gbq38u/spider_gaming/code_claws/firmware/README-claw-radio.md

# Пульт двух клешней: прошивки и подключение

## Файлы

- `claw_remote_nano/claw_remote_nano.ino` — прошивка пульта Arduino Nano.
- `../esp_spider3_copy_20261016134133/esp_spider3_copy_20261016134133.ino` — существующая программа ESP32 с подключённым управлением клешнями.
- `../esp_spider3_copy_20261016134133/claw_radio_esp32.h` — код приёмника и движения шести сервоприводов. Хранить в той же папке, что и основной `.ino`.

Установить библиотеки **RF24 (TMRh20)** и **Adafruit PWM Servo Driver Library** (включая Adafruit BusIO). Основная программа ESP32 также требует свои прежние библиотеки micro-ROS. RF24 и Adafruit используются в актуальных API `begin/openWritingPipe/openReadingPipe/read/write` и `writeMicroseconds`.

## Подключение пульта

| Элемент | Nano |
| --- | --- |
| Левый VRx / VRy / SW | A0 / A1 / D3 |
| Правый VRx / VRy / SW | A2 / A3 / D4 |
| Радио CE / CSN / SCK / MOSI / MISO | D9 / D10 / D13 / D11 / D12 |

Кнопки джойстиков замыкают SW на GND, поэтому в коде включена внутренняя подтяжка. Оба джойстика питаются от 5 В Nano. Питание YL-105 — 5 В после MT3608, nRF24L01+ вставляется в адаптер и получает 3,3 В с него. Выходы Nano D9/D10/D13/D11 подключать к адаптеру **через четыре делителя 1 кОм последовательно + 1,8 кОм на землю**, как на схеме пульта; MISO идёт прямо на D12. Конденсаторы 10 мкФ и 100 нФ стоят на выходе 3,3 В адаптера. Если при исправной разводке приём не работает, уровень MISO 3,3 В может быть недостаточен для конкретного 5-вольтового Nano; тогда нужен согласующий буфер.

## Разъёмы клешней платы v13

| Клешня | Движение | Разъём | PCA9685, канал | Питание +5 В |
| --- | --- | --- | --- | --- |
| Левая | Поворот | J19 | 0x40, 6 | группа C |
| Левая | Подъём | J20 | 0x40, 5 | группа B |
| Левая | Захват | J21 | 0x40, 4 | группа A |
| Правая | Поворот | J22 | 0x41, 6 | группа C |
| Правая | Подъём | J23 | 0x41, 5 | группа B |
| Правая | Захват | J24 | 0x41, 4 | группа A |

Каждый разъём: контакт 1 — сигнал, 2 — соответствующие +5 В, 3 — GND. Не объединять три группы +5 В. На ESP32 радио: CE=GPIO25, CSN=GPIO26, SCK=GPIO18, MOSI=GPIO23, MISO=GPIO19. J_RF.2 подаёт 5 В на **вход** YL-105. IRQ=GPIO27 коду не нужен: приём идёт опросом; перемычка RF8 необязательна для работы этой прошивки.

## Поведение

Каждый джойстик управляет своей клешнёй. Влево/вправо — поворот; вперёд/назад — подъём/опускание. Чем дальше отклонён рычаг, тем быстрее движение. Отпущенный рычаг сохраняет положение. Одно нажатие кнопки переключает открыто/закрыто. Повторяемые пакеты несут именно состояние захвата, поэтому потерянный пакет не создаёт второго переключения. При потере радиосвязи более чем на 300 мс движение поворота и подъёма прекращается, захват остаётся в последнем состоянии.

При включении держите джойстики по центру: Nano калибрует четыре середины за ~0,13 с. ESP32 не двигает клешни до первого корректного пакета; затем задаёт нейтральные 1500 мкс и плавно переводит губки к состоянию «открыто». При загрузке прошивки и первой проверке снимите качалки: реальные нули, крайние углы и направление электрического хода SG90 зависят от установки. Константы `kAxisSign` в пульте и `kYawDirection`, `kPitchDirection`, `kMinUs`, `kMaxUs`, `kOpenUs`, `kClosedUs` в приёмнике позволяют откалибровать направления и пределы. Текущий диапазон 1250–1750 мкс — начальный осторожный диапазон, а не подтверждённый полный ход геометрии клешней. Геометрические положения −73° (рабочее) и +20° (ходовое) из модели не равны углам PWM.

Чтобы не задеть передние ноги, сначала проверьте их разведение, а затем расширяйте предел опускания клешней. Перед сведением ног поднимайте клешни. Программный ограничитель столкновений с ногами пока не задан: для него нужна проверенная фактическая кинематика вместе с установленными сервами.

## Встраивание в программу паука

В существующем `.ino` приёмник уже подключён. Там `pca2` имеет адрес **0x40**, а `pca1` — **0x41**, поэтому вызов `ClawRadio::begin(pca2, pca1, pcaBusMutex)` дан именно в таком порядке. Код создаёт отдельную задачу ESP32, которая продолжает принимать радио, пока micro-ROS ждёт агента. Общий мьютекс защищает I²C от одновременной записи ног и клешней. Управление ногами остаётся в прежних таймерах micro-ROS.

Таблица `servoPorts` и привязка `legLF/.../legRR` в существующем `.ino` были приведены к текущей плате v13: J1–J3 — левая передняя нога; J4–J6 — правая передняя; J7–J9 — левая средняя; J10–J12 — правая средняя; J13–J15 — левая задняя; J16–J18 — правая задняя. Если физически ваши 18 серв подключены в другом порядке, адаптируйте эту таблицу перед включением.

Полная компиляция основной программы требует установленной среды Arduino ESP32, RF24, Adafruit и micro-ROS с `spider_interfaces`. В этом окружении Arduino CLI и RF24 не установлены; код обоих новых модулей проверен компилятором C++11 с заглушками зависимостей. Работа на фактическом пульте и клешнях требует проверки при сборке.
