gbq38u/spider_gaming/images/2026-10-07 08.31.48.jpg

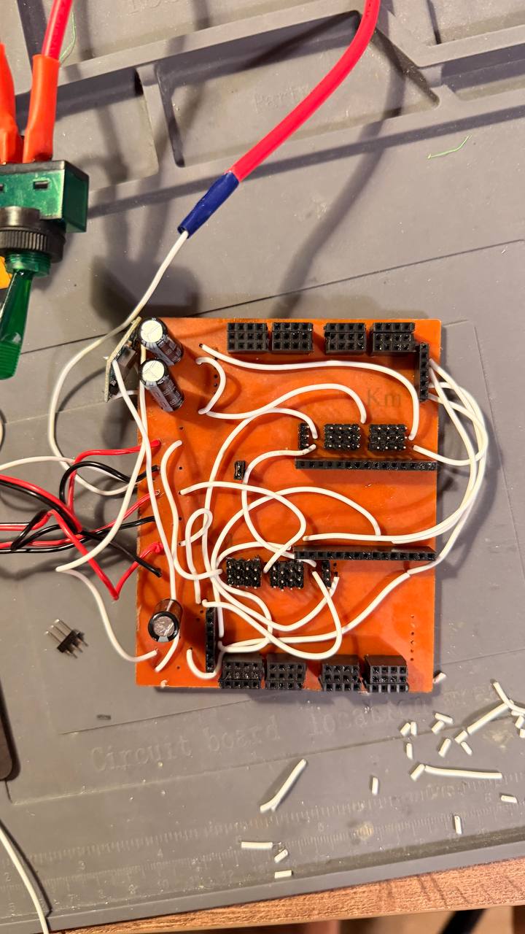
images/2026-10-07 08.31.48.jpg
