gbq38u/spider_gaming/images/2026-10-07 08.31.58.jpg

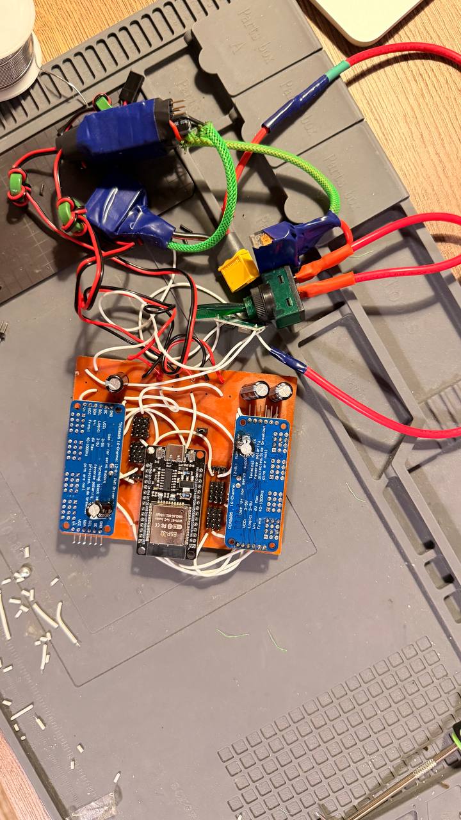
images/2026-10-07 08.31.58.jpg
