gbq38u/spider_gaming/images/2026-10-07 08.32.05.jpg

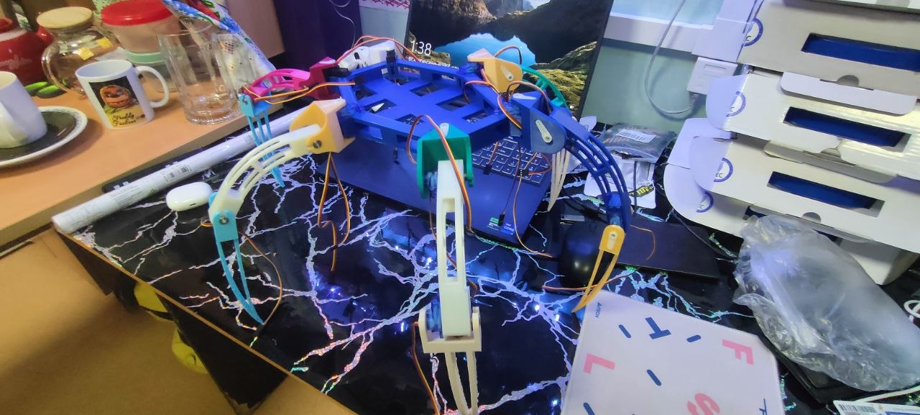
images/2026-10-07 08.32.05.jpg
