gbq38u/spider_gaming/images/desmos_screen1.png

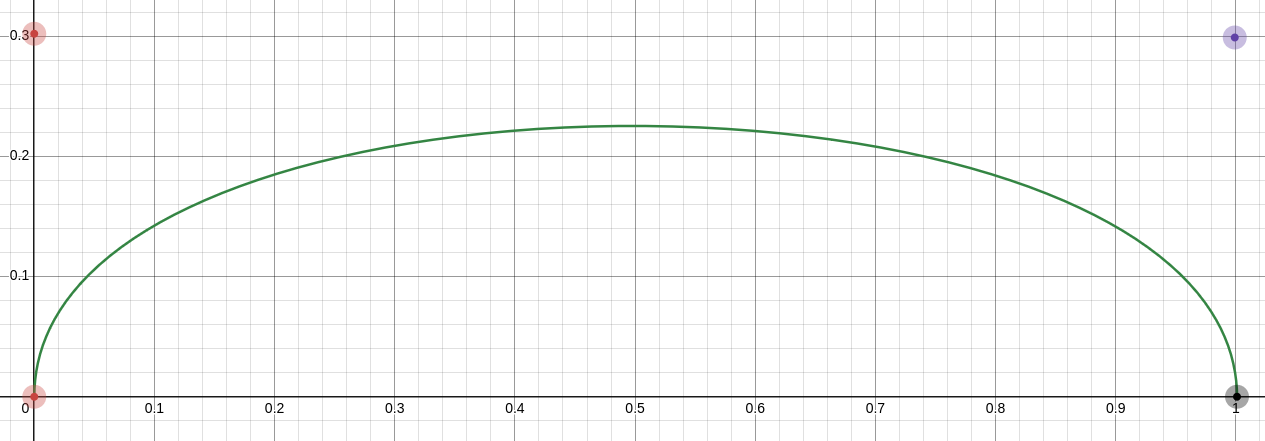
images/desmos_screen1.png
