gbq38u/spider_gaming/parts/spider_remote_2joystick_PETG_v1/preview/controller_with_hardware_concept.png

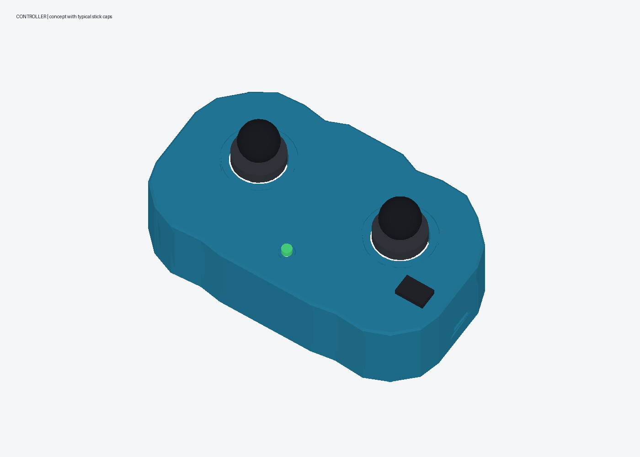
parts/spider_remote_2joystick_PETG_v1/preview/controller_with_hardware_concept.png
