gbq38u/spider_gaming/parts/claws_petg_SG90_2x3_v12 2/README_RU.md

# Две трёхприводные клешни для паука — версия 12

Размеры в миллиметрах. Основа проекта — предоставленные `main_frame.STL`, `servo.STL`, `Assembled_spider_light.STL` и детали ног из папки `SPIDER_LIGHT`. Оригинальную раму перепечатывать не требуется. В просмотрочных сборках вертикаль робота — Z, движение вперёд — Y. Перед корпуса соответствует стороне +Z исходной `main_frame.STL`.

## Что печатать

В `print_stl/` находятся детали, уже уложенные на плоскость печати. Для каждой стороны (`left`, `right`) нужно **по одной**: `yaw_base`, `pitch_cradle`, `boom`, `gripper_holder`, `gear_bridge`, `jaw_carrier`, `jaw_driven`, `jaw_passive` — всего 16 основных STL. `jaw_carrier` — отдельная несущая деталь под ведущей шестернёй, которую качалка прижимает к серве. Детали не нужно отражать или копировать. Отдельных гаек и печатных проставок для осей подшипников **нет**. Две направляющие `drill_jig` необязательны. Перед основным комплектом напечатайте по одному `servo_fit_coupon`, `horn_fit_coupon`, `bearing_fit_coupon`, `m3_pilot_fit_coupon` и проверьте реальные серву, качалку, подшипник и усилие вкручивания M3. Детали разных версий между собой не смешивать.

`claws_assembly_work.stl` и `claws_assembly_walk.stl` показывают обе клешни с сервами, штатными качалками и подшипниками. `claw_left_assembly_work.stl` и `claw_right_assembly_work.stl` показывают стороны отдельно. `spider_with_claws_reference.stl` показывает рабочую позу с разведёнными передними ногами; `spider_with_claws_unspread_reference.stl` — сравнение с исходным положением ног. Эти файлы **не печатать**. `preview/` содержит изображения и схему сверления.

## Крепление к раме

Сверлить раму на стороне +Z исходной `main_frame.STL`:

| Клешня | X, мм | Z, мм | Отверстий |
|---|---|---|---:|
| Левая | 81 и 89 | 251 и 258 | 4 |
| Правая | 97 и 105 | 251 и 258 | 4 |

Сверло Ø3,3–3,4 мм. Четыре отверстия каждого основания приходятся на сплошную поперечину рамы; разметка рамы остаётся прежней. Оси боксов поворота расположены **над креплениями передних ног**, в просмотрочной сборке X=115 и 241,5 мм, Y=333 мм. Палуба бокса поднята на 32 мм над верхом рамы. Её держат две стойки сечением 6 × 3,6 мм, две перемычки шириной 5,2 мм и косые распорки Ø5,8 мм. Минимальный оценочный зазор от нижнего края подшипникового узла до передней ноги в рабочей позе — около 10,5 мм. Приложите напечатанные основания и проверьте полный ход передних ног **до сверления**. Ориентир крепежа: восемь болтов M3×30 с шайбами и гайками; длину уточните по реальной раме. Схема `preview/mount_drilling.png` не является бумажным шаблоном 1:1.

## Штатные качалки и подшипники

Все три сервы каждой клешни используют **штатную одноплечую качалку**, установленную на шлиц сервы. По исходному `hanger.STL` габарит в плане — 21,673 × 7,33 мм, толщина ступицы 4 мм. У неё нижние 2 мм занимает в основном ступица, а длинное плечо лежит на уровне 2–4 мм. Теперь на всех трёх приводных осях **между сервой и длинным плечом качалки остаётся сплошная печатная полка толщиной 2 мм**. Ступица проходит через центральное отверстие, качалка устанавливается с наружной стороны полки и прижимает её к серве. Наружные окна дают доступ к центральному винту вала и винтам плеча; сама полка под плечом больше не прорезана сквозным пазом. Исходная модель качалки **не содержит отверстий под винты плеча**, поэтому после примерки разметьте и просверлите небольшие пилоты в полке через отверстия вашей физической качалки. Не сверлите их наугад по STL качалки.

На противоположной стороне каждого из трёх приводных шарниров стоит подшипник **3×8×4 мм** (тип MR83 или эквивалент). Ещё один такой же подшипник поддерживает пассивную губку каждой клешни: всего **восемь**. В `spider_leg_L1.STL` измерена посадка Ø8,1 мм глубиной 3,9 мм; в `spider_leg_L3_new_new.STL` — Ø8,0 мм глубиной 3,9 мм. Для PETG выбран карман Ø8,1 мм глубиной 4,1–4,2 мм. Подшипник запрессовывается наружным кольцом в карман, его внутреннее кольцо надевается на винт M3; гайки и отдельной печатной проставки нет. Пилот Ø2,7 мм для винта остаётся гладким в STL — резьбу формирует сам винт при аккуратной установке. Встроенный выступ Ø4,8 мм ответной детали подходит к внутреннему кольцу. Реальное усилие посадки проверьте на пробнике `bearing_fit_coupon`.

- **Поворот:** полка `pitch_cradle` находится между сервой и плечом качалки; качалку ставят **сверху, после установки этой детали**. Подшипник запрессовывается **снизу** в её нижнюю вилку. До установки сервы в `yaw_base` вкрутите M3 **изнутри бокса вниз** через сквозной пилот Ø2,7 мм. Головка Ø≤5,5 мм и высотой ≤3 мм утапливается в гнездо Ø5,9 × 3,2 мм заподлицо с дном бокса. Нижний выступ винта входит прямо в отверстие внутреннего кольца подшипника, без гайки.
- **Подъём:** полка внутренней ветви `boom` находится между сервой и качалкой; качалку ставят **снаружи после установки плеча**. Подшипник запрессовывается **снаружи** в короткую ветвь вилки. Ветвь и неподвижное ухо находятся близко к корпусу сервы; торец уха отстоит от корпуса на 0,35 мм по его STL. До установки сервы в `pitch_cradle` вкрутите M3 **изнутри бокса в сторону уха** через сквозной пилот Ø2,7 мм. Головка Ø≤5,5 × 3 мм утапливается в гнездо Ø5,9 × 3,4 мм, а выступ винта входит прямо во внутреннее кольцо подшипника. Ось подъёма горизонтальна, параллельна поверхности хода.
- **Захват:** `jaw_carrier` сначала ставится между сервой и качалкой. Качалка надевается **с наружной стороны держателя** и прижимает его полку к серве. После закрепления качалки ставится отдельная ведущая шестерня с пальцем `jaw_driven` и крепится к держателю двумя M2×8 через совпадающие отверстия. Ведущая губка имеет **цельный** выступ Ø4,8 мм и гладкий пилот Ø2,7 мм. Подшипник запрессовывается сверху в съёмный мост `gear_bridge`; короткий винт M3 проходит через его внутреннее кольцо и вкручивается прямо в выступ губки.
- У держателя `jaw_carrier` корень сделан сплошным круглым, с отверстиями M2 внутри контура. Наружных круглых ушек возле качалки больше нет.
- **Пассивная губка:** её шестерня сцеплена с ведущей шестернёй и поворачивается вокруг собственной неподвижной оси. Дополнительный подшипник 3×8×4 мм запрессовывается в ступицу `jaw_passive`. Наружное кольцо вращается с губкой; выступ Ø4,8 мм на нижнем мосту `gear_bridge` входит в отверстие Ø5,2 мм губки и упирается только во внутреннее кольцо. Винт M3 без головки проходит через центр подшипника и вкручивается в пилот Ø2,7 мм моста. Поэтому губку не прижимает головка винта, и она свободно вращается без гайки или отдельной проставки.

Ориентир длины от нижней стороны головки: поворот **M3×12**, подъём **M3×8**. Концы этих винтов доходят до наружной стороны внутреннего кольца и не требуют гайки. Для ведущей и пассивной губок используйте по **M3×8 установочному винту без головки** с внутренним шестигранником: каждый проходит через 4 мм подшипника и входит примерно на 4 мм в пилот ответной детали. Длины проверьте с фактическим крепежом и подшипником: винт не должен упираться в серву или зажимать наружное кольцо.

Упрощённая `servo.STL` не содержит выходного шлица и отверстий в крепёжных ушках, а `hanger.STL` не содержит отверстий под винты. Поэтому шаг отверстий качалки, осевую высоту реального шлица, длину штатного центрального винта и усилие посадки подшипника **обязательно проверьте по физическим деталям** на пробниках. Может потребоваться центральный винт той же резьбы чуть длиннее комплектного. Если качалка из вашего набора отличается по контуру, подгоните параметрический карман до печати полного комплекта.

## Порядок сборки

1. Проверьте посадки на четырёх пробниках. Внутренний размер бокса сервы 23,36 × 12,36 мм под корпус из предоставленного STL 23 × 12 мм; четыре малых выступа создают прижим около 0,15 мм на сторону. Крепёжных ушек и пилотных отверстий для них на печатных боксах нет: серва вставляется в бокс плотно, как на фотографиях ног. Качалка снаружи прижимает ведомую деталь к серве, противоположный подшипник поддерживает ось. PETG и калибровка принтера влияют на усилие вставки: убедитесь на пробнике, что серва входит с небольшим усилием и не болтается. На `m3_pilot_fit_coupon` проверьте, что ваш M3 уверенно вкручивается в гладкий Ø2,7 мм без трещин и сильного люфта.
2. Прикрутите `yaw_base` к раме. Пока боксы пустые, **вкрутите изнутри** винты M3×12 и утопите головки в посадки. Затем установите сервы поворота. Запрессуйте подшипники в нижние вилки `pitch_cradle` **снизу**. Поставьте `pitch_cradle` на ось сервы и выступающий M3; её полка окажется между сервой и будущей качалкой. Теперь наденьте качалку снаружи на шлиц, закрепите центральным винтом и после примерки закрепите плечо качалки в полке малыми саморезами через фактические отверстия качалки. Проверьте свободное вращение.
3. Пока боксы подъёма `pitch_cradle` пустые, **вкрутите изнутри** винты M3×8 и утопите их. Установите сервы подъёма. Запрессуйте боковые подшипники в короткие ветви `boom` **снаружи**. Поставьте `boom` на ось сервы и подшипниковую опору. Его полка должна оказаться между сервой и качалкой. Наденьте качалку с наружной стороны плеча, закрепите центральным винтом, затем малыми саморезами через реальные отверстия качалки закрепите плечо в полке. Длинные плечи обращены к внутреннему пространству робота.
4. Прикрутите `gripper_holder` к концам плеч: по два болта M3, расстояние между отверстиями 12 мм. Установите третьи сервы.
5. Поставьте `jaw_carrier` поверх вала сервы захвата. Наденьте качалку **снаружи этого держателя**, закрепите её центральным винтом и малыми саморезами в полке по отверстиям физической качалки. После этого прикрутите `jaw_driven` к держателю двумя M2×8. Запрессуйте подшипник в `jaw_passive`, установите губку над неподвижным выступом нижнего моста `gear_bridge` и вкрутите через подшипник установочный M3×8 в пилот моста. Совместите зубья обеих шестерён. Прикрутите `gear_bridge` к держателю **тремя** винтами M2 через стойки: две сзади по краям сервы, третья вынесена за серву по центру. Затем запрессуйте второй подшипник в верхний колпачок и вкрутите через его центр установочный M3×8 в пилот `jaw_driven`. Проверьте лёгкое вращение обеих губок.

## Печать и рабочие положения

Ориентир для PETG: сопло 0,4 мм, слой 0,2 мм, 4–5 периметров, заполнение 25–35 %. Длинные плечи и крепления к раме печатайте с пятью периметрами; шестерни — плотными. Для поднятой палубы и перемычек `yaw_base` требуются поддержки от стола. Для `pitch_cradle`, `gripper_holder` и верхнего колпачка `gear_bridge` проверьте поддержки в слайсере; в полостях серв их заблокируйте. Перед нагрузкой проверьте удержание на качалках, свободный ход всех подшипников и достаточный момент серв.

## Проверки этой версии

`source/verify_joints.py` проверяет геометрию исходной качалки относительно всех трёх полок, её наружный доступ, центральные проходы ступиц, совпадение осей M2/M3, подшипники и крепление ведущей шестерни к `jaw_carrier`. `source/audit_motion.py` проверяет пересечения твёрдых тел в ходе губок и подъёма, а также на сетке совместных положений двух клешней. Все отдельные печатные STL проверены на замкнутость и единственность тела. Это проверка цифровой геометрии; высоту реального шлица сервы, положение отверстий реальной качалки, усилие посадок и удержание подшипника проверьте на пробниках и при сборке.

Рабочая обзорная поза: подъём −73°, поворот 0°, передние ноги разведены примерно на 50° слева и 30° справа. Кончики губок опускаются примерно до 0,6 мм над плоскостью пола и выступают вперёд до Y≈452,5 мм при максимуме исходного робота Y≈434,4 мм. Колпачок подшипника захвата остаётся не ниже 15,7 мм над полом. Ходовая поза: подъём +20°, поворот 0°. Углы являются геометрическими углами модели, **не значениями PWM**.

**Проверенные пределы для управления обеими установленными клешнями:** подъём от −73° до +55°; горизонтальный поворот левой клешни от 0° до 15° **наружу**, правой от 0° до 15° **наружу**; одновременное раскрытие обеих клешней от 0° до 20° (ведущая губка левой поворачивается на +20°, правой на −20°, пассивные — навстречу). Ходовая поза +20° входит в этот диапазон. Внутренний поворот даже около 5° уже пересекает держатели двух клешней; при наружном повороте 20° в нижней позе плечо касается основания. При одновременном раскрытии обеих губок на 30° пересекаются ведущие губки. Поэтому эти пределы нужно задать в программе как ограничения, а не использовать полный ход сервы. Предельное закрытие задайте по фактическому касанию накладок губок, не доводя их до взаимного пересечения.

По дискретной поверхности исходной STL оценочный зазор плеча до соответствующей разведённой передней ноги при наружном повороте 15° составляет около 8,3 мм слева и 7,1 мм справа; неподвижные основания при повороте верхних звеньев от −35° до +55° дают минимальный оценочный зазор около 7,8 мм. Это проверка модели, а не гарантия для проводов и реальных люфтов. Сначала разведите передние ноги, затем опускайте клешни; перед сведением ног поднимите клешни. Пределы движения определяйте вручную без нагрузки и затем задайте в программе.
