gbq38u/spider_gaming/parts/spider_remote_2joystick_PETG_v1/README_RU.md

# Пульт для двух клешней паука

Комплект STL для печати из PETG. Форма корпуса — многогранный геймпад с двумя боковыми хватами. Все размеры в миллиметрах.

## Что печатать

- `print_stl/controller_body.stl` — основной корпус, **1 шт.** Файл уже лежит лицевой панелью на плоскости печати.
- `print_stl/controller_snap_lid.stl` — задняя крышка с защёлкой и лотком под готовый держатель одной 18650, **1 шт.** Файл уже лежит наружной стороной на плоскости печати.
- `print_stl/joystick_fit_coupon.stl` — маленький пробник посадки джойстика, **1 шт. сначала**. Он повторяет отверстие и расстояния до четырёх крепёжных стоек основного корпуса.

Крышка и корпус — разные детали; копировать или отражать STL не нужно. Изображения в `preview/` только для просмотра; `controller_with_hardware_concept.png` показывает условные габариты органов управления.

## Размеры посадок

| Узел | Размер в модели | Как устанавливать |
|---|---:|---|
| Два джойстика типа KY‑023 | Проём Ø28; расчётная плата 34 × 26,3 | Изнутри, винтами M2.5 в четыре стойки на каждый модуль |
| Сетка стоек джойстика | 20,3 × 26,2; пилоты Ø2,1 | Сверить по **своим** двум платам на пробнике |
| KCD11, 2 контакта | Окно 15,25 × 10,25; панель 2,4 | Защёлкнуть сверху |
| Обычный светодиод 5 мм | Сквозное Ø5,15; сверху неглубокая фаска Ø8 | Установить изнутри, закрепить подходящим держателем или каплей клея |
| Держатель одной 18650 | Лоток 79 × 22,6; расчётная высота держателя до 21,5 | На крышку, с фиксацией двумя стяжками через прорези |

Наружный габарит корпуса — 156 × 93 × 40 мм. У джойстика плата размещается примерно на 13 мм ниже лицевой плоскости; выводы и провода остаются внутри. В крышке по сторонам от держателя есть участки для Nano, радиомодуля и другой небольшой электроники с прорезями под стяжки. Для них не заданы отверстия под конкретные платы, так как их исполнение зависит от выбранных модулей. Предусмотрите запас длины проводов к батарее: держатель выходит вместе с крышкой.

**Важно о точной посадке:** на присланном фото указан общий размер джойстика 26 × 40 × 22 мм, но не показаны координаты его четырёх монтажных отверстий. Сетка 20,3 × 26,2 мм взята как типовая для KY‑023. У продаваемых плат она может отличаться. Перед печатью полного корпуса приложите **обе реальные платы** к `joystick_fit_coupon.stl` и проверьте также ход колпачка в Ø28. Если не совпадает, измените параметры `HOLE_DX`, `HOLE_DY` и/или диаметр проёма в `source/build_remote.py` и пересоберите STL.

KCD11 бывает нескольких производителей: окно 10 × 15 мм соответствует указанному пользователем выключателю; его фактические защёлки и толщину допустимой панели также проверьте перед установкой. Держатель 18650, светодиод, джойстики и выключатель в комплект STL не входят.

## Сборка и печать

1. Проверьте джойстики на пробнике. В пилоты Ø2,1 вкручиваются M2.5 без напечатанной резьбы; не перетягивайте винты в PETG.
2. Закрепите две платы джойстиков изнутри корпуса. Контакты ориентируйте в удобную сторону для проводки. Защёлкните выключатель в прямоугольное окно; установите светодиод в круглое.
3. Закрепите готовый держатель 18650 в лотке крышки стяжками. Остальные платы привяжите к прорезям в боковых зонах крышки. Проверьте, что провода не попадают в джойстики или защёлку.
4. Сначала заведите левый жёсткий язычок крышки в левое боковое окно корпуса. Затем нажмите правый край до щелчка. Для открытия нажмите на правую лапку через боковое окно и подденьте крышку у выемки сзади; не тяните за провод батареи.

Печать PETG: сопло 0,4 мм, слой 0,2 мм, 3–4 периметра, 20–30 % заполнения. Корпус и крышка в файлах уже ориентированы для печати. У окон защёлки и на кончике её крючка осмотрите превью слайсера; при необходимости поставьте только местные поддержки. Не ставьте поддержки внутри отверстий пилотов и посадки джойстика.

Одна 18650 не даёт стабилизированные 5 В для классического Nano: схему питания, преобразователь, защиту аккумулятора и зарядку нужно выбрать и подключить отдельно. Корпус предоставляет место, но не заменяет электрическую схему.

## Источники размеров и границы проверки

- [Чертёж KY‑023 с габаритом платы 34 × 26,3 мм и отверстиями Ø3](https://www.auselectronicsdirect.com.au/assets/brochures/TA0051.pdf). У разных клонов геометрия отличается.
- [KCD11, посадочное окно 10 × 15 мм](https://www.qpinconn.com/en/proshow.php?id=850).
- [Пример готового держателя одной 18650 размером 77,1 × 21,1 × 21,5 мм](https://www.kenenghardware.com/ky-37011-1-1-18650-battery-holder/).

Проверено скриптом `source/validate_remote.py`: 2 STL корпуса/крышки и пробник — замкнутые сетки, в расчётном собранном положении крышка не пересекается с корпусом, а номинальные платы джойстиков и держатель не пересекают стенки. Физическое усилие защёлки, посадка конкретных модулей и печатные допуски требуют проверки на реальных деталях.
