gbq38u/spider_gaming/parts/claws_petg_SG90_2x3_v12 2/preview/grip_bearing_pilot_detail.png

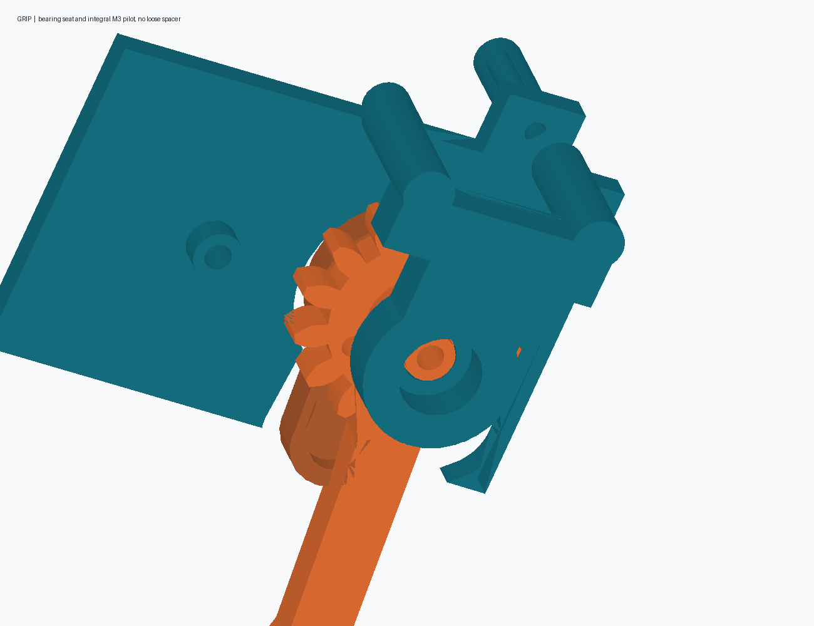
parts/claws_petg_SG90_2x3_v12 2/preview/grip_bearing_pilot_detail.png
