gbq38u/spider_gaming/parts/claws_petg_SG90_2x3_v12 2/preview/walk_iso.png

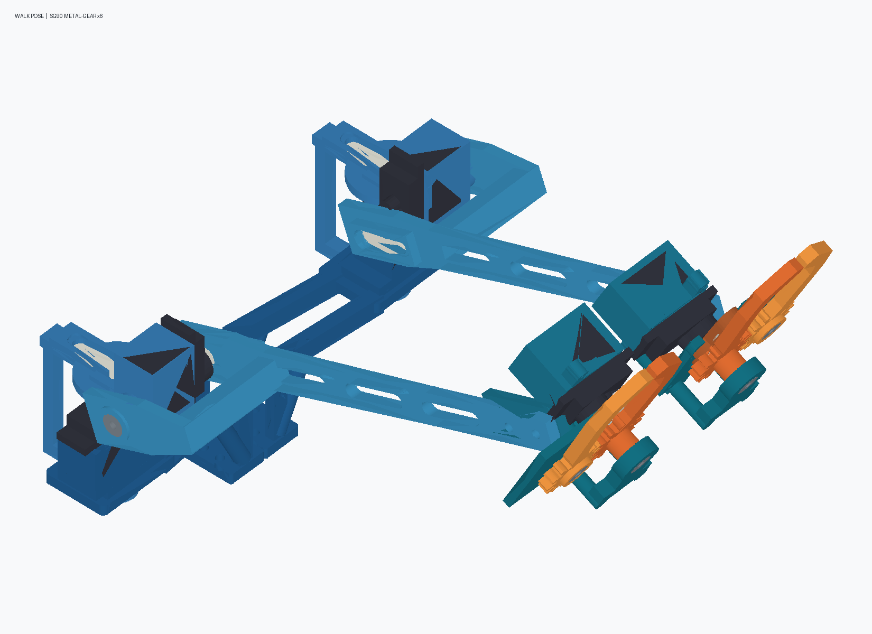
parts/claws_petg_SG90_2x3_v12 2/preview/walk_iso.png
