gbq38u/spider_gaming/parts/spider_remote_2joystick_PETG_v1/preview/controller_open_back.png

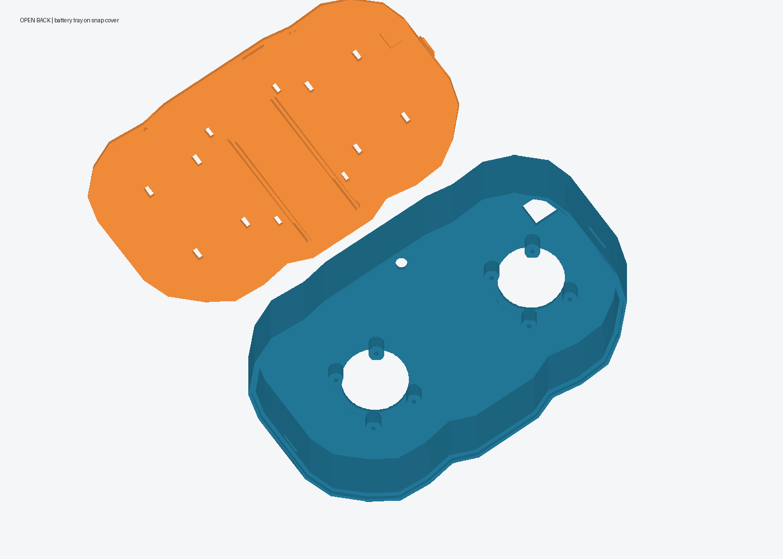
parts/spider_remote_2joystick_PETG_v1/preview/controller_open_back.png
