gbq38u/spider_gaming/parts/SPIDER_LIGHT/Assembled_leg_short.SLDASM

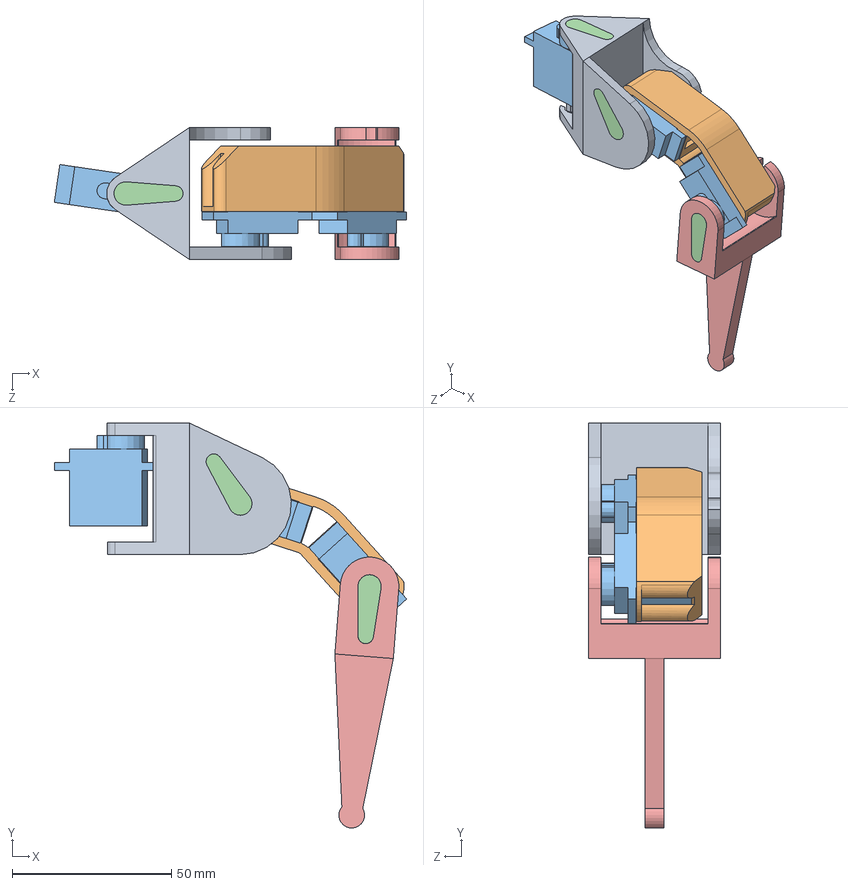
[picture p30: CAD file, 2026-11-03]
parts/SPIDER_LIGHT/Assembled_leg_short.SLDASM
110.6 x 127.1 x 41.4 mm
spider_leg_L1
spider_leg_L2_new
servo x 3
hanger x 3
spider_leg_L3_new_new
