gbq38u/spider_gaming/parts/claws_petg_SG90_2x3_v12 2/reference_assemblies/claw_left_assembly_work.stl

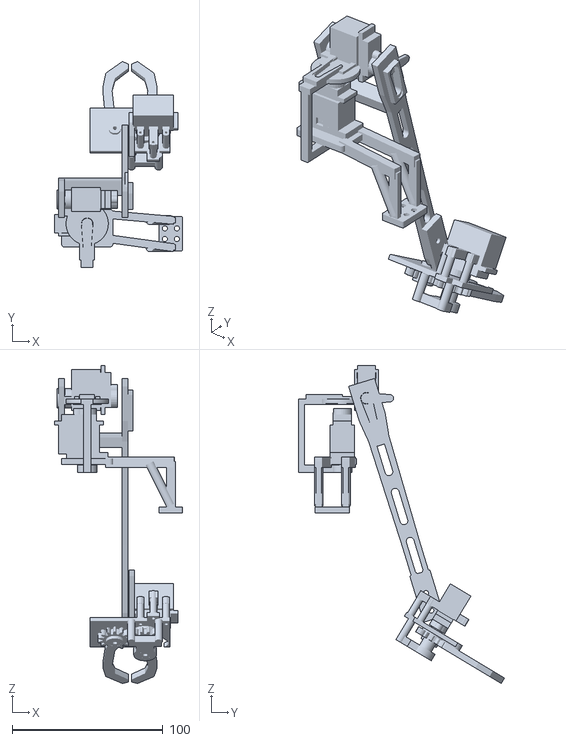
[picture p31: CAD file, 2026-11-03]
parts/claws_petg_SG90_2x3_v12 2/reference_assemblies/claw_left_assembly_work.stl
84.9 x 136.5 x 210.7
