gbq38u/spider_gaming/parts/SPIDER_LIGHT/Assembled_spider_light.SLDASM

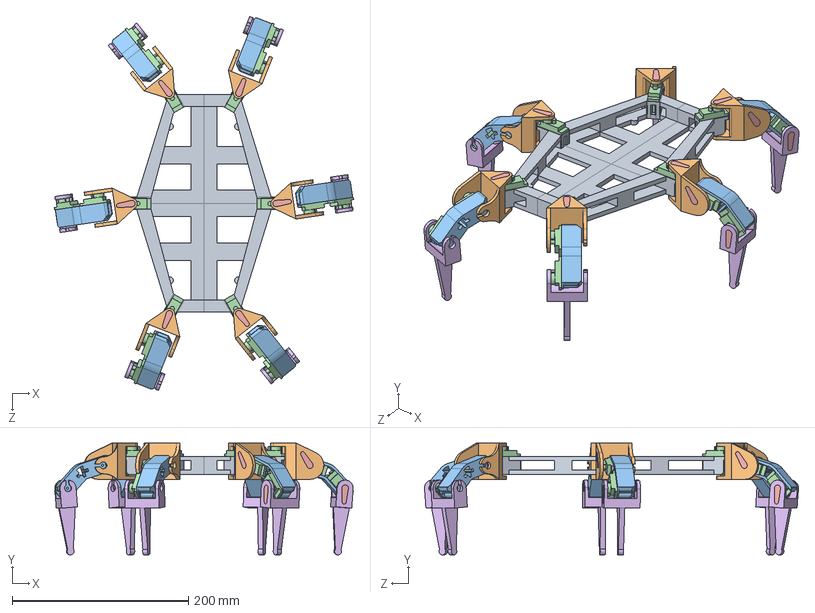
[picture p32: CAD file, 2026-11-03]
parts/SPIDER_LIGHT/Assembled_spider_light.SLDASM
340.4 x 127.1 x 425.0 mm
main_frame
spider_leg_L1 x 6
spider_leg_L2_new x 6
servo x 18
hanger x 18
spider_leg_L3_new_new x 6
