gbq38u/spider_gaming/parts/claws_petg_SG90_2x3_v12 2/reference_assemblies/claws_assembly_walk.stl

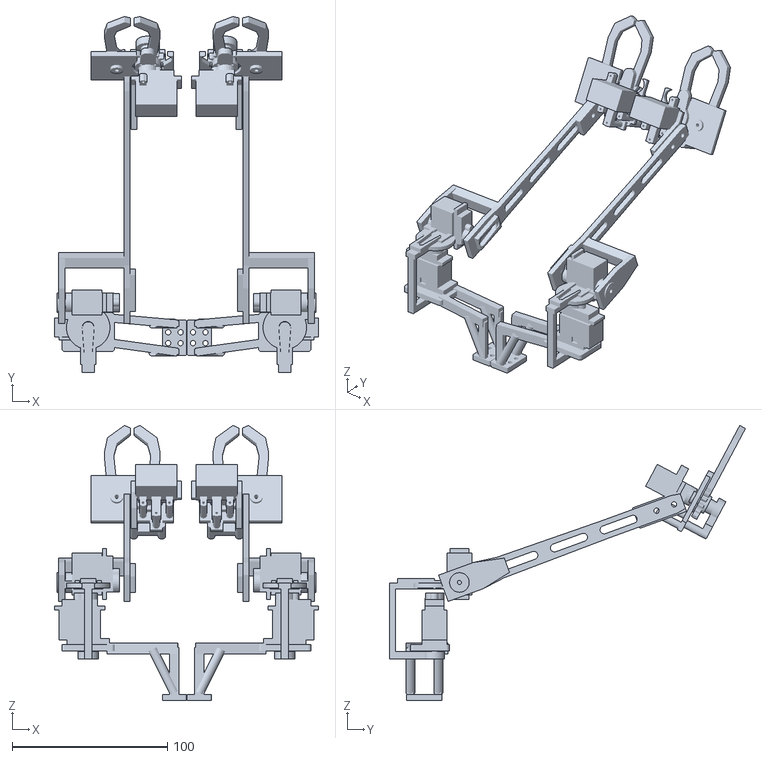
[picture p34: CAD file, 2026-11-03]
parts/claws_petg_SG90_2x3_v12 2/reference_assemblies/claws_assembly_walk.stl
169.9 x 229.1 x 177.1
