gbq38u/spider_gaming/parts/SPIDER_LIGHT/main_frame.STL

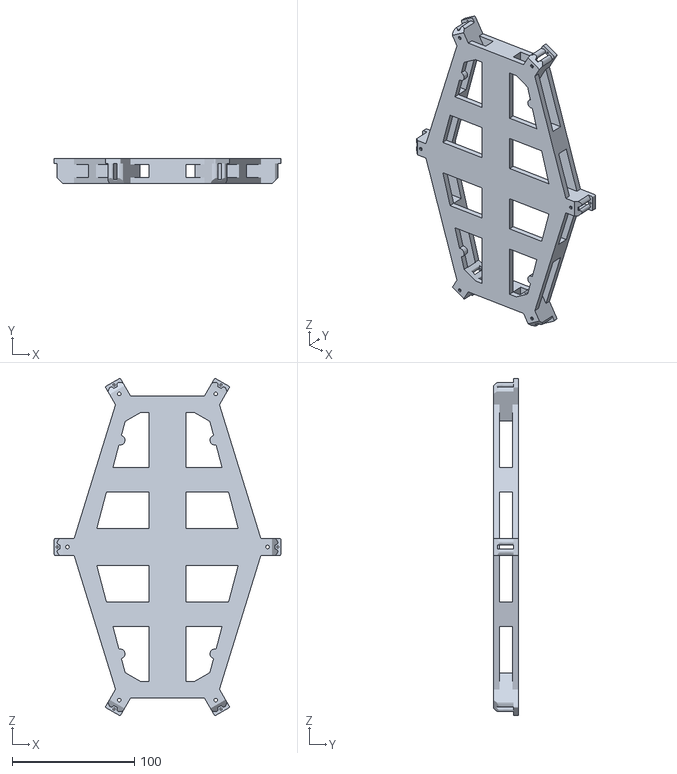
[picture p36: CAD file, 2026-11-03]
parts/SPIDER_LIGHT/main_frame.STL
185.5 x 20.5 x 275.8
