gbq38u/spider_gaming/parts/claws_petg_SG90_2x3_v12 2/print_stl/pitch_cradle_right.stl

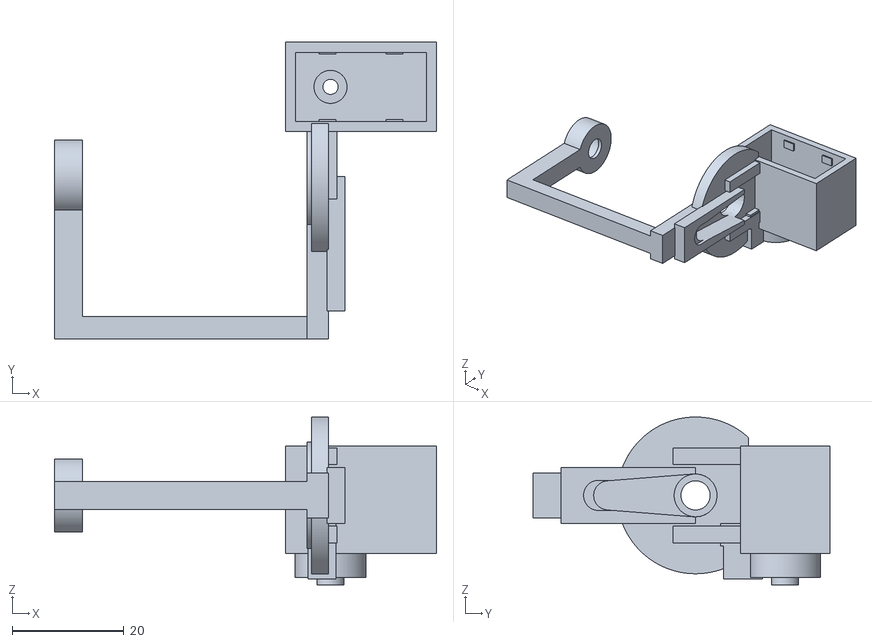
[picture p37: CAD file, 2026-11-03]
parts/claws_petg_SG90_2x3_v12 2/print_stl/pitch_cradle_right.stl
68.2 x 53.0 x 30.0
