gbq38u/spider_gaming/parts/claws_petg_SG90_2x3_v12 2/reference_assemblies/spider_with_claws_reference.stl

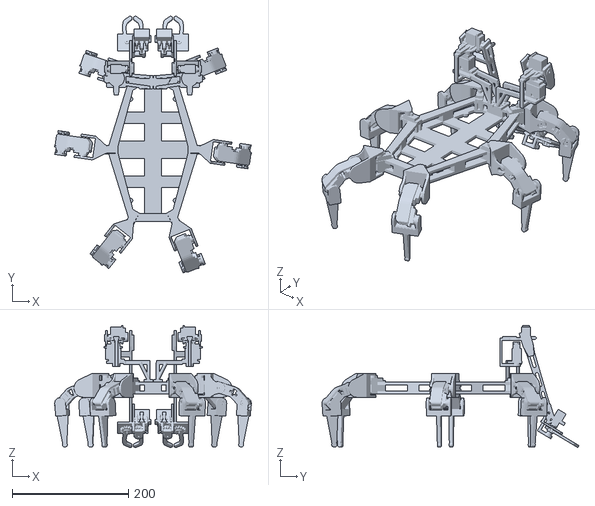
[picture p38: CAD file, 2026-11-03]
parts/claws_petg_SG90_2x3_v12 2/reference_assemblies/spider_with_claws_reference.stl
340.4 x 443.1 x 210.7
