gbq38u/spider_gaming/parts/spider_remote_2joystick_PETG_v1/print_stl/controller_body.stl

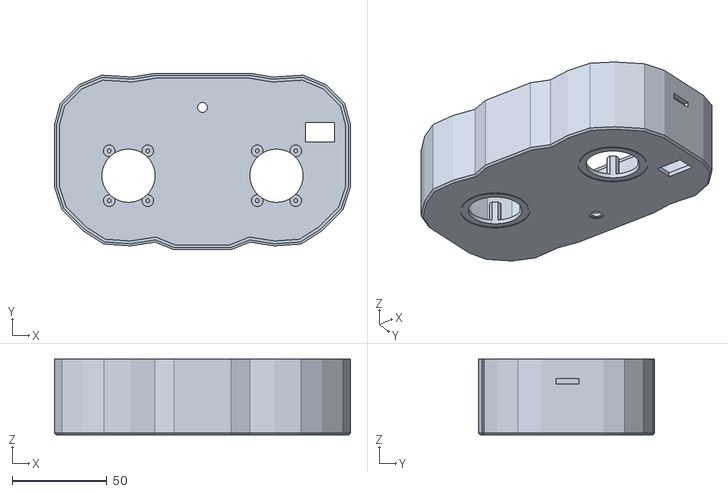
[picture p39: CAD file, 2026-11-03]
parts/spider_remote_2joystick_PETG_v1/print_stl/controller_body.stl
156.0 x 93.0 x 40.0
