gbq38u/spider_gaming/parts/носочек/spider_leg_L3_new_new.STL

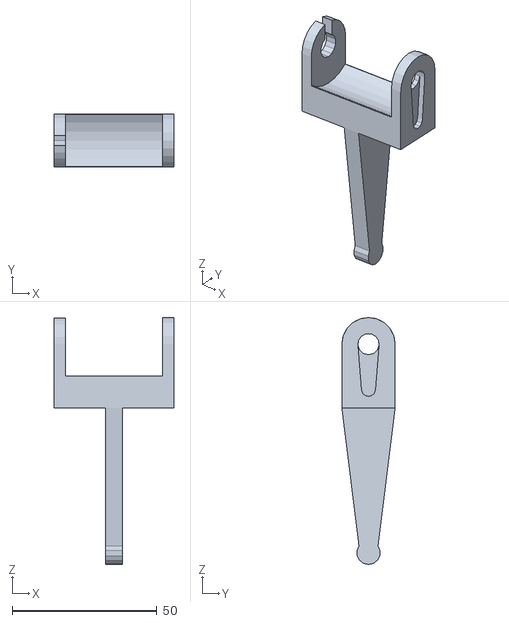
[picture p40: CAD file, 2026-11-03]
parts/носочек/spider_leg_L3_new_new.STL
41.4 x 18.4 x 85.2
