gbq38u/spider_gaming/parts/claws_petg_SG90_2x3_v12 2/print_stl/gripper_holder_left.stl

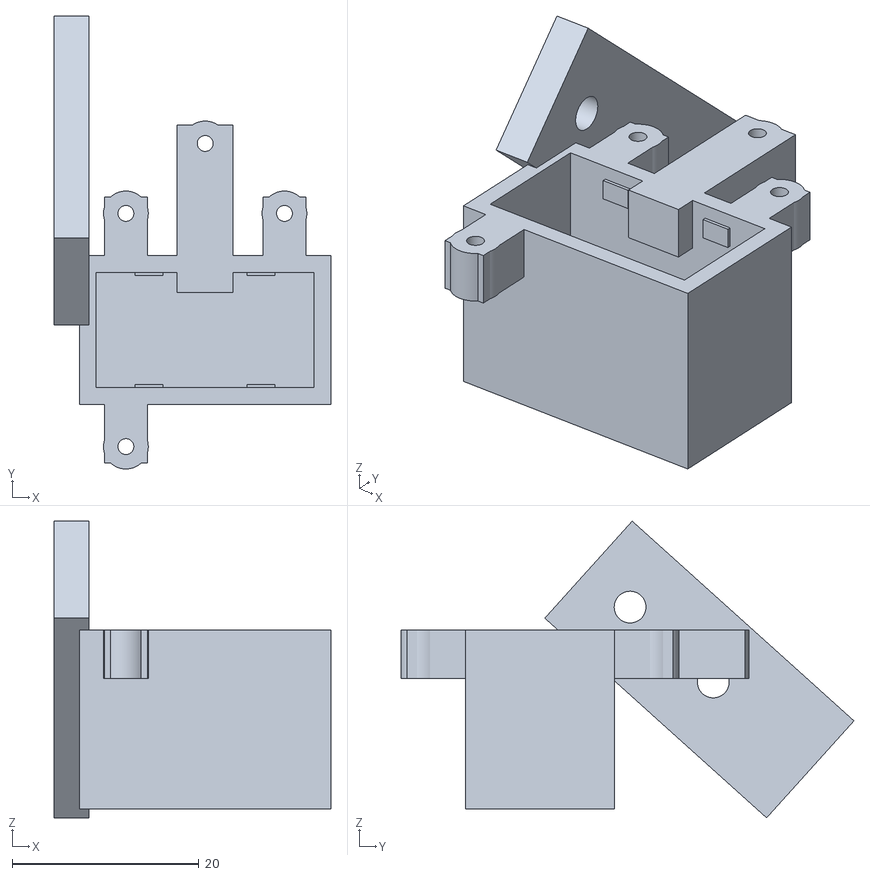
[picture p41: CAD file, 2026-11-03]
parts/claws_petg_SG90_2x3_v12 2/print_stl/gripper_holder_left.stl
29.7 x 48.6 x 31.8
