gbq38u/spider_gaming/parts/SPIDER_LIGHT/servo.STL

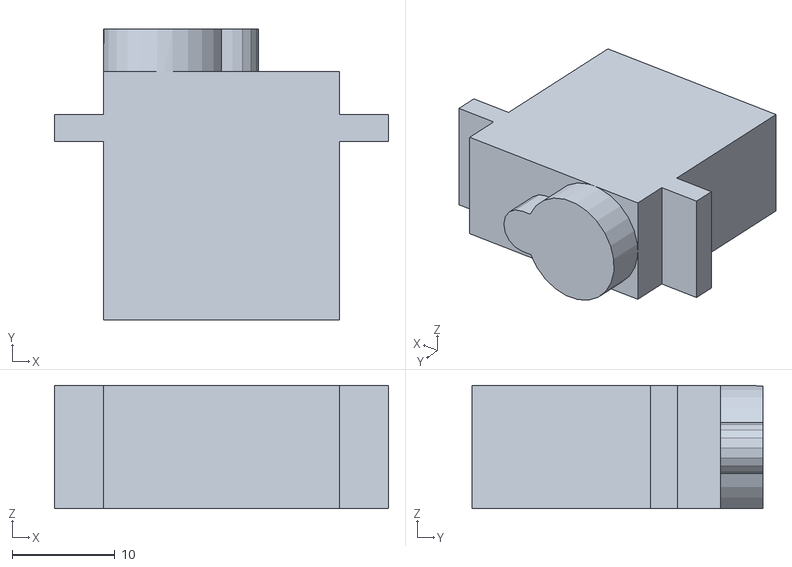
[picture p42: CAD file, 2026-11-03]
parts/SPIDER_LIGHT/servo.STL
32.5 x 28.3 x 12.0
