gbq38u/spider_gaming/parts/spider_remote_2joystick_PETG_v1/print_stl/joystick_fit_coupon.stl

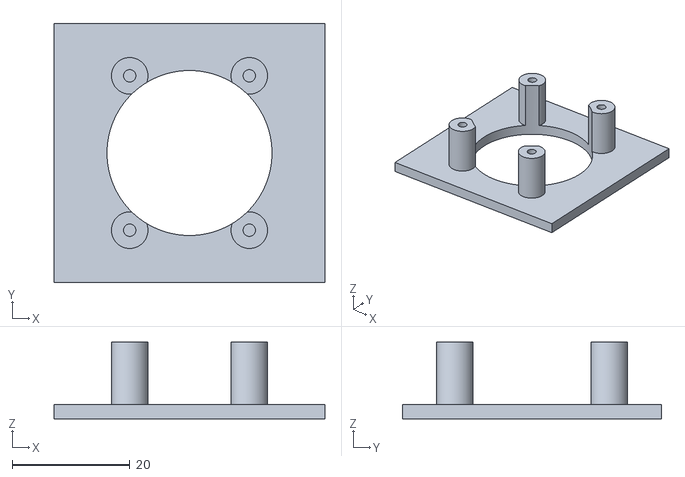
[picture p43: CAD file, 2026-11-03]
parts/spider_remote_2joystick_PETG_v1/print_stl/joystick_fit_coupon.stl
46.0 x 44.0 x 13.0
