gbq38u/spider_gaming/parts/носочек/spider_leg_L3_TPU_sock_flex_pad.stl

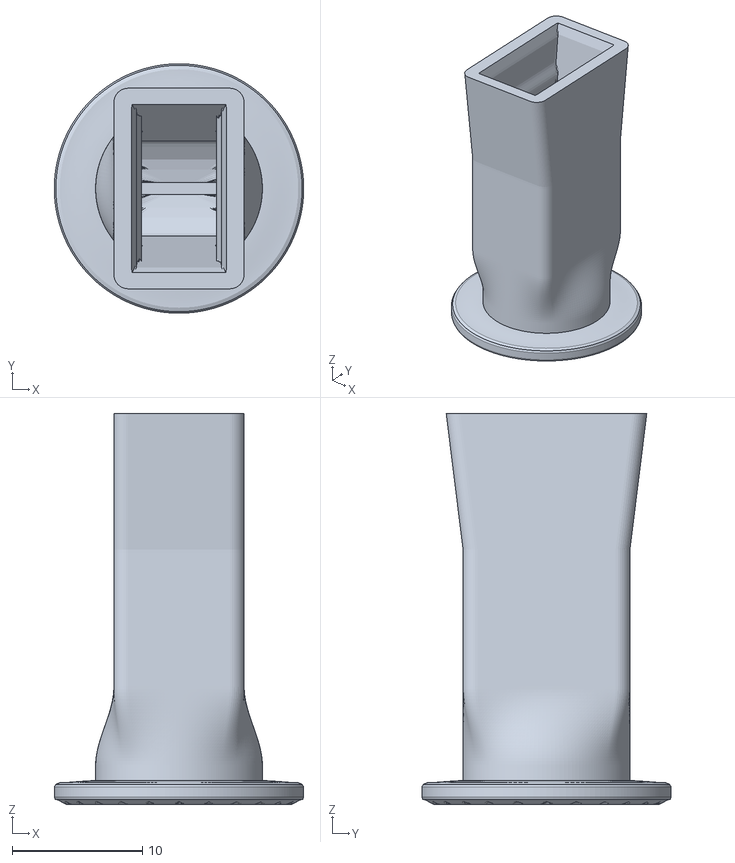
[picture p44: CAD file, 2026-11-03]
parts/носочек/spider_leg_L3_TPU_sock_flex_pad.stl
19.1 x 19.1 x 30.0
