gbq38u/spider_gaming/parts/claws_petg_SG90_2x3_v12 2/print_stl/servo_fit_coupon.stl

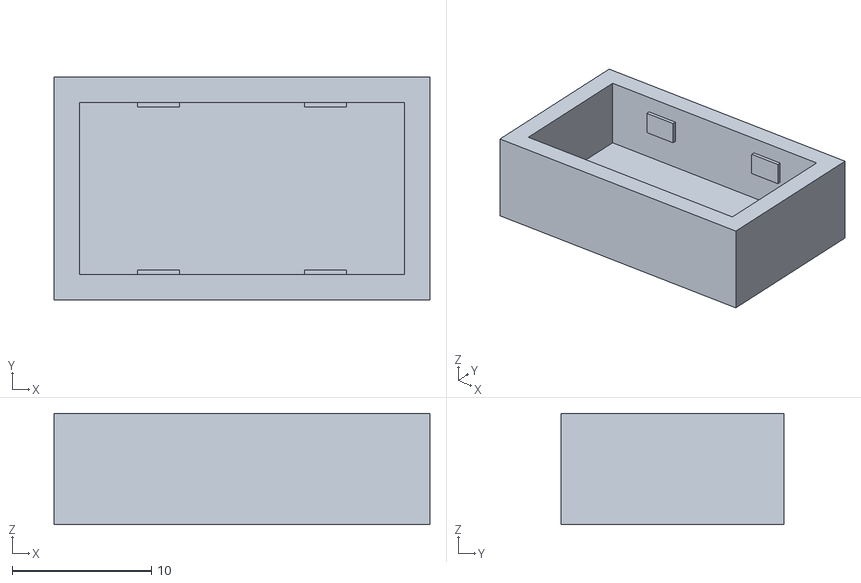
[picture p45: CAD file, 2026-11-03]
parts/claws_petg_SG90_2x3_v12 2/print_stl/servo_fit_coupon.stl
27.0 x 16.0 x 8.00
