gbq38u/spider_gaming/parts/claws_petg_SG90_2x3_v12 2/reference_assemblies/reference_bearing_3x8x4.stl

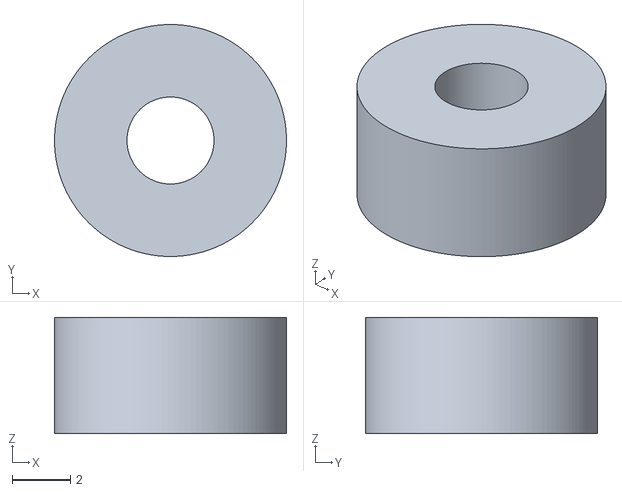
[picture p46: CAD file, 2026-11-03]
parts/claws_petg_SG90_2x3_v12 2/reference_assemblies/reference_bearing_3x8x4.stl
8.00 x 8.00 x 4.00
