gbq38u/spider_gaming/parts/spider_remote_2joystick_PETG_v1/print_stl/controller_snap_lid.stl

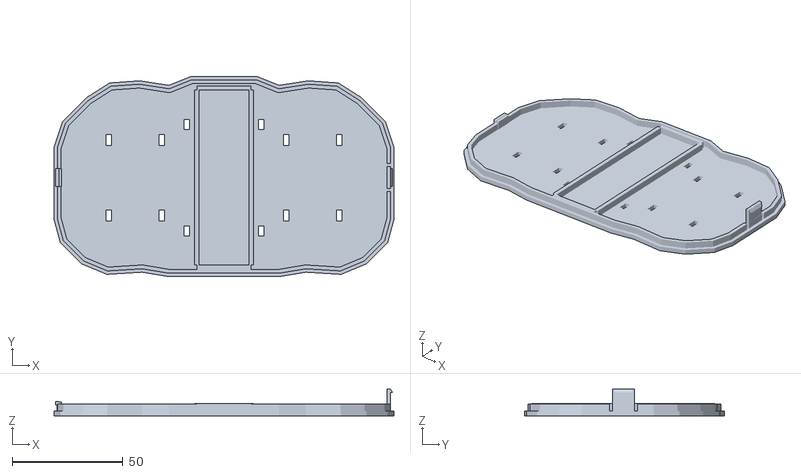
[picture p47: CAD file, 2026-11-03]
parts/spider_remote_2joystick_PETG_v1/print_stl/controller_snap_lid.stl
153.3 x 90.3 x 11.9
