gbq38u/spider_gaming/parts/носочек/spider_leg_L3_TPU_sock_round_foot.stl

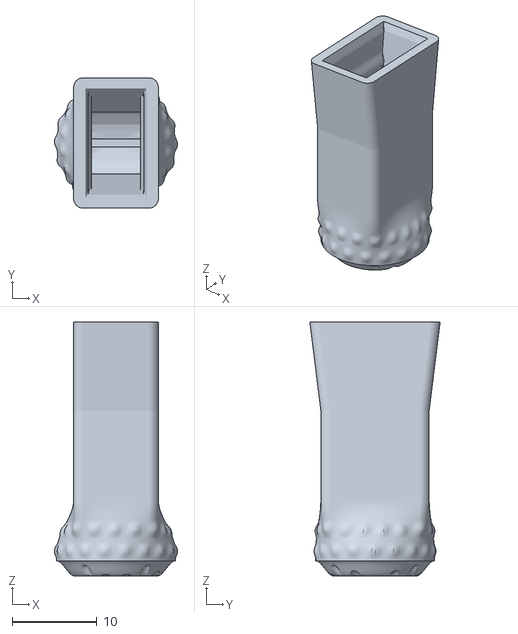
[picture p48: CAD file, 2026-11-03]
parts/носочек/spider_leg_L3_TPU_sock_round_foot.stl
14.6 x 15.4 x 30.0
