gbq38u/spider_gaming/parts/claws_petg_SG90_2x3_v12 2/print_stl/jaw_driven_right.stl

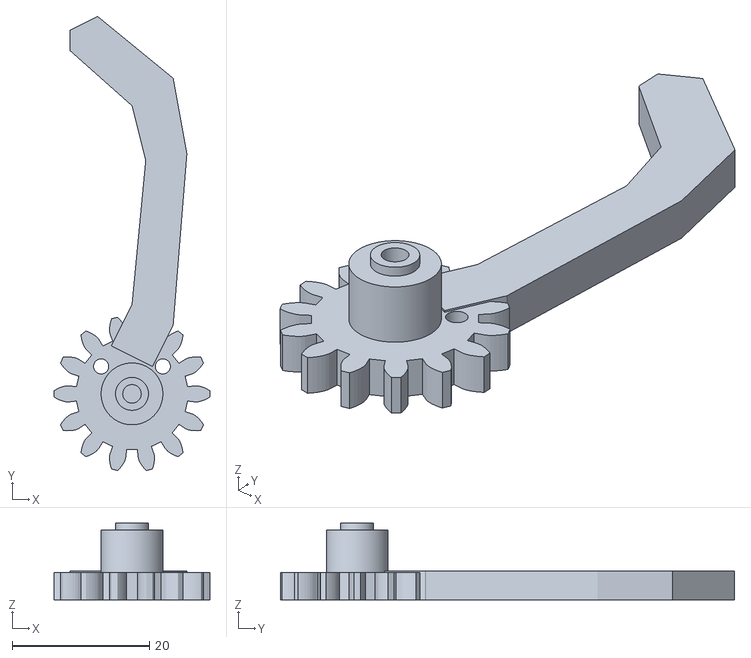
[picture p49: CAD file, 2026-11-03]
parts/claws_petg_SG90_2x3_v12 2/print_stl/jaw_driven_right.stl
22.7 x 66.2 x 11.2
