gbq38u/spider_gaming/parts/claws_petg_SG90_2x3_v12 2/print_stl/yaw_base_right.stl

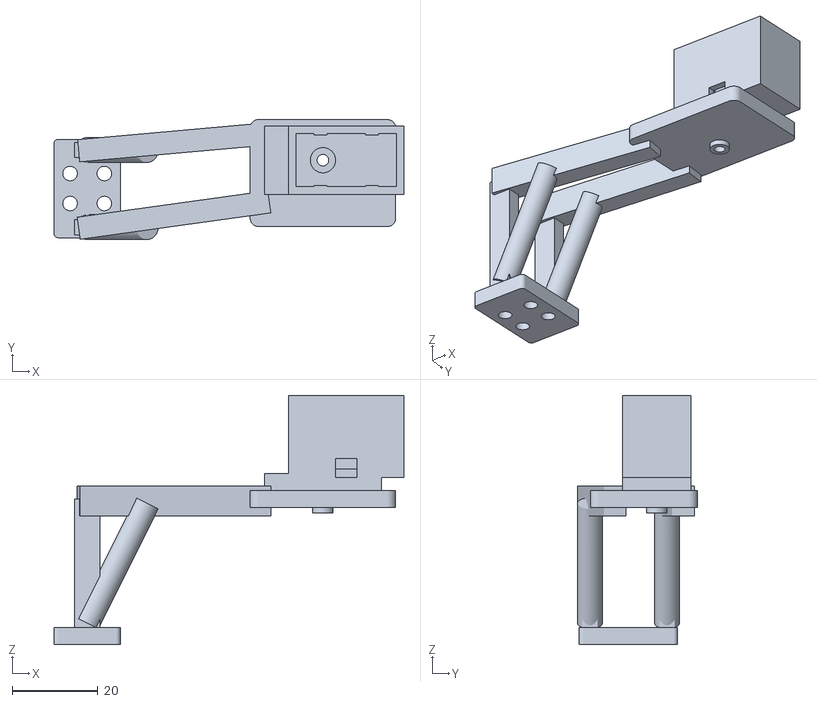
[picture p50: CAD file, 2026-11-03]
parts/claws_petg_SG90_2x3_v12 2/print_stl/yaw_base_right.stl
81.7 x 28.0 x 58.2
