gbq38u/spider_gaming/parts/SPIDER_LIGHT/spider_leg_L1.STL

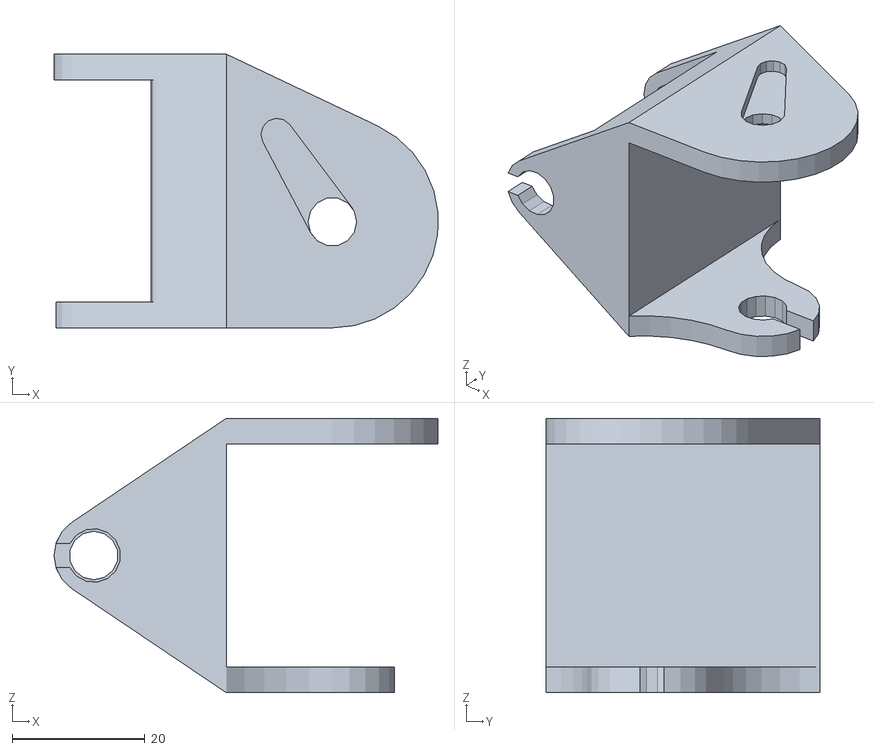
[picture p51: CAD file, 2026-11-03]
parts/SPIDER_LIGHT/spider_leg_L1.STL
57.9 x 41.3 x 41.4
