gbq38u/spider_gaming/parts/claws_petg_SG90_2x3_v12 2/print_stl/drill_jig_right.stl

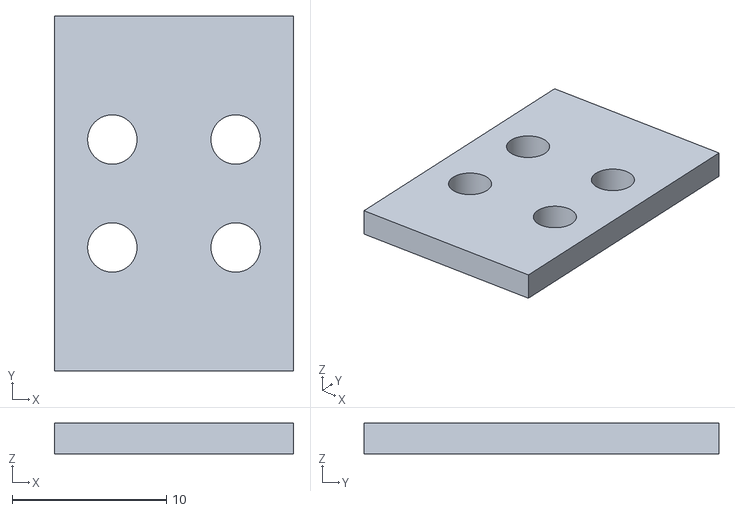
[picture p52: CAD file, 2026-11-03]
parts/claws_petg_SG90_2x3_v12 2/print_stl/drill_jig_right.stl
15.5 x 23.0 x 2.00
