gbq38u/spider_gaming/parts/SPIDER_LIGHT/hanger.STL

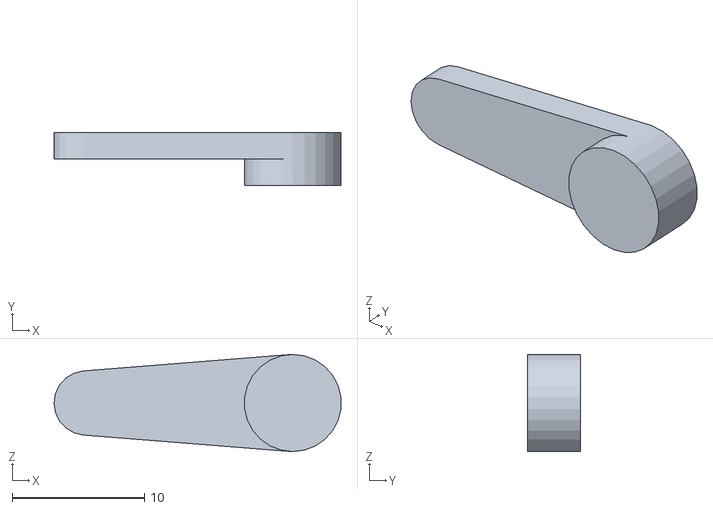
[picture p53: CAD file, 2026-11-03]
parts/SPIDER_LIGHT/hanger.STL
21.7 x 4.00 x 7.33
