gbq38u/spider_gaming/parts/claws_petg_SG90_2x3_v12 2/print_stl/boom_left.stl

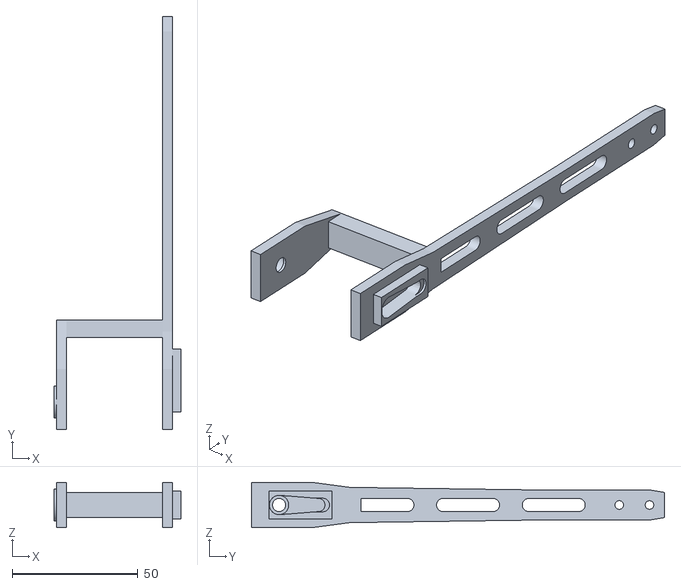
[picture p54: CAD file, 2026-11-03]
parts/claws_petg_SG90_2x3_v12 2/print_stl/boom_left.stl
50.4 x 164.0 x 18.0
