gbq38u/spider_gaming/parts/SPIDER_LIGHT/spider_leg_L2_new.STL

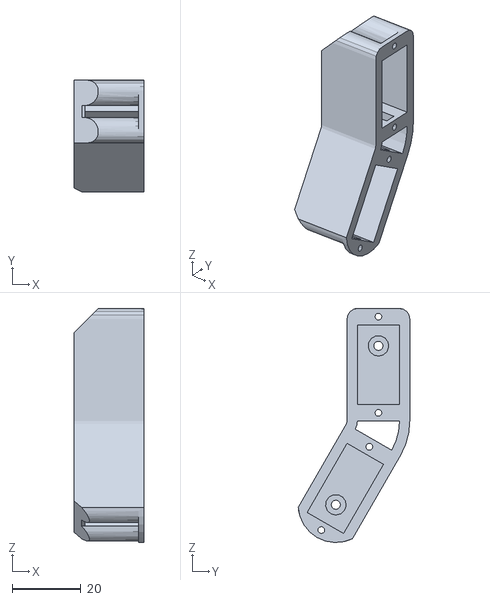
[picture p55: CAD file, 2026-11-03]
parts/SPIDER_LIGHT/spider_leg_L2_new.STL
20.5 x 32.5 x 68.1
