gbq38u/spider_gaming/parts/claws_petg_SG90_2x3_v12 2/print_stl/horn_fit_coupon.stl

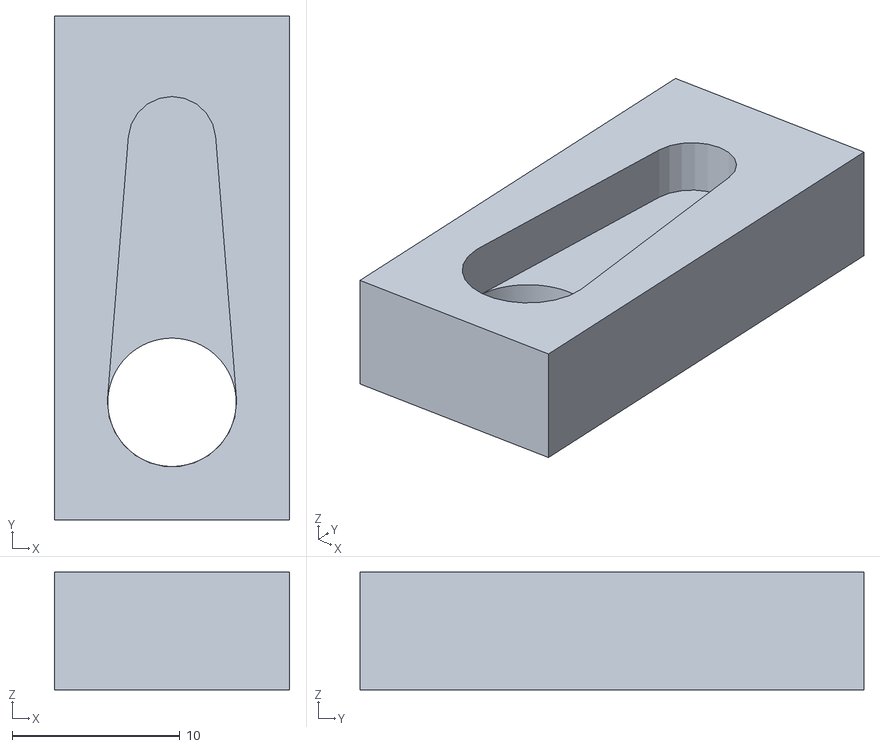
[picture p56: CAD file, 2026-11-03]
parts/claws_petg_SG90_2x3_v12 2/print_stl/horn_fit_coupon.stl
14.0 x 30.0 x 7.00
