gbq38u/spider_gaming/parts/claws_petg_SG90_2x3_v12 2/reference_assemblies/spider_front_legs_spread_reference.stl

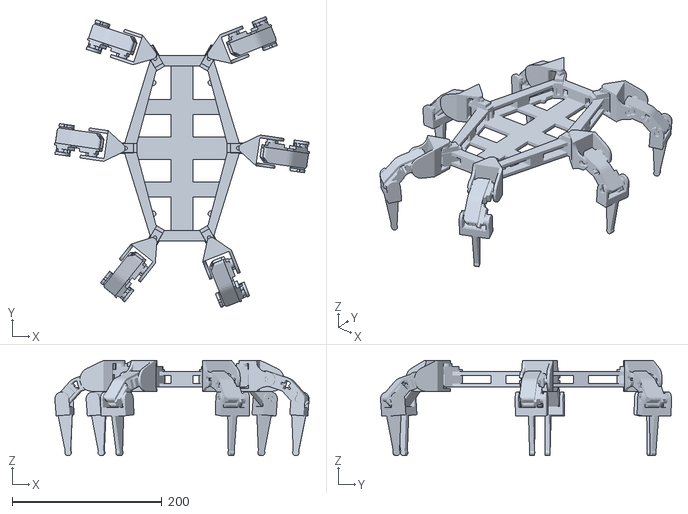
[picture p57: CAD file, 2026-11-03]
parts/claws_petg_SG90_2x3_v12 2/reference_assemblies/spider_front_legs_spread_reference.stl
340.4 x 388.2 x 127.1
