gbq38u/spider_gaming/parts/claws_petg_SG90_2x3_v12 2/print_stl/m3_pilot_fit_coupon.stl

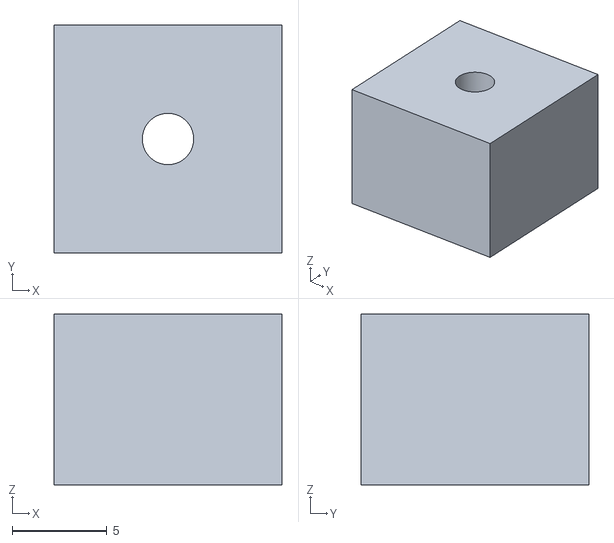
[picture p58: CAD file, 2026-11-03]
parts/claws_petg_SG90_2x3_v12 2/print_stl/m3_pilot_fit_coupon.stl
12.0 x 12.0 x 9.00
