gbq38u/spider_gaming/parts/claws_petg_SG90_2x3_v12 2/print_stl/jaw_carrier_left.stl

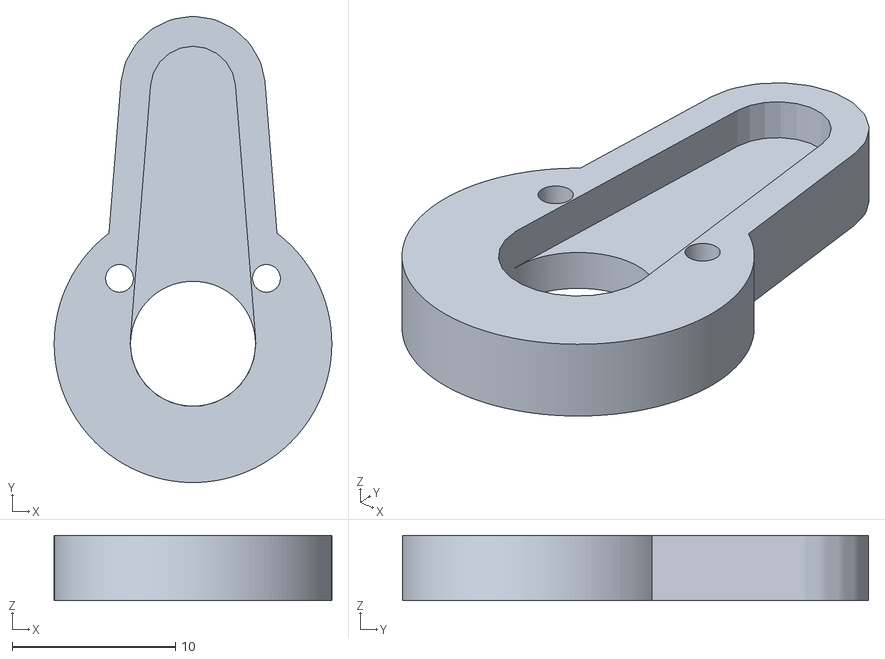
[picture p60: CAD file, 2026-11-03]
parts/claws_petg_SG90_2x3_v12 2/print_stl/jaw_carrier_left.stl
17.0 x 28.5 x 4.00
