gbq38u/spider_gaming/parts/claws_petg_SG90_2x3_v12 2/print_stl/jaw_passive_left.stl

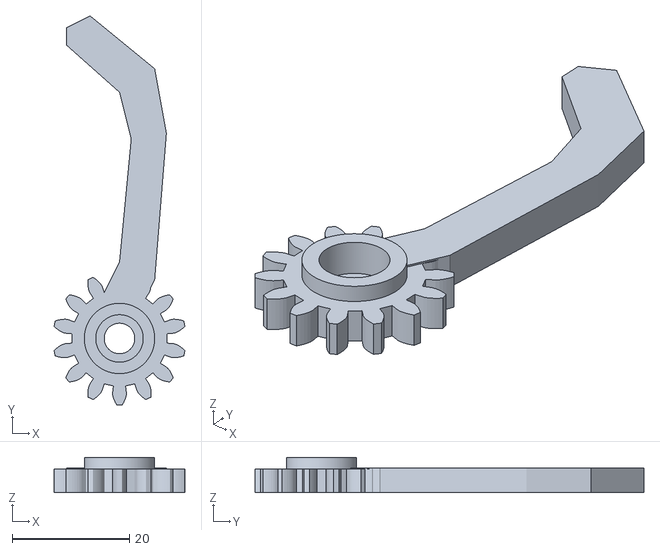
[picture p61: CAD file, 2026-11-03]
parts/claws_petg_SG90_2x3_v12 2/print_stl/jaw_passive_left.stl
22.3 x 66.4 x 6.00
