gbq38u/spider_gaming/parts/claws_petg_SG90_2x3_v12 2/print_stl/gear_bridge_left.stl

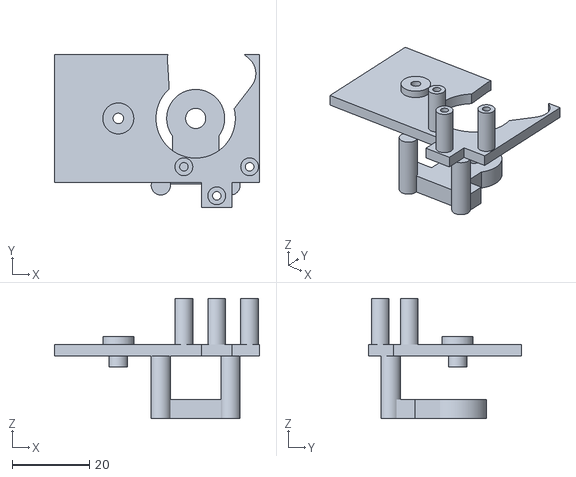
[picture p62: CAD file, 2026-11-03]
parts/claws_petg_SG90_2x3_v12 2/print_stl/gear_bridge_left.stl
53.0 x 39.5 x 31.1
