gbq38u/spider_gaming/(list of files, cad)

Other CAD files:
parts/claws_petg_SG90_2x3_v12 2/reference_assemblies/spider_with_claws_unspread_reference.stl
parts/claws_petg_SG90_2x3_v12 2/print_stl/pitch_cradle_left.stl
parts/claws_petg_SG90_2x3_v12 2/print_stl/drill_jig_left.stl
parts/claws_petg_SG90_2x3_v12 2/print_stl/jaw_driven_left.stl
parts/claws_petg_SG90_2x3_v12 2/print_stl/yaw_base_left.stl
parts/claws_petg_SG90_2x3_v12 2/print_stl/boom_right.stl
parts/claws_petg_SG90_2x3_v12 2/print_stl/gripper_holder_right.stl
parts/claws_petg_SG90_2x3_v12 2/print_stl/gear_bridge_right.stl
parts/claws_petg_SG90_2x3_v12 2/print_stl/jaw_carrier_right.stl
parts/claws_petg_SG90_2x3_v12 2/print_stl/jaw_passive_right.stl
parts/SPIDER_LIGHT/Assembled_leg_short.STL
parts/SPIDER_LIGHT/Assembled_spider_light.STL
