gbq38u/spider_gaming/wiring/platav2/интерактивный пульт.html

# Пульт — полная интерактивная схема

18650 1S → MT3608 5,0 В → Arduino Nano и YL‑105; два джойстика управляют двумя клешнями. Выберите цепь для подсветки контактов.

### Пульт: общая схема соединений

Arduino Nano 5 В · 2 джойстика · 18650 1S · MT3608 · YL‑105 + nRF24L01+PA/LNA

Показать соединения Есть съёмная перемычка JP_PWR

18650 (+) → SW1 → MT3608 IN+; 18650 (−) → MT3608 IN−.

MT3608 OUT+ 5,0 В → JP_PWR → Nano 5V, оба VCC джойстиков, YL‑105 VCC.

MT3608 OUT− → общий GND Nano, джойстиков и YL‑105.

LED1: шина +5 В → R10 1 кОм → анод; катод → GND.

#### 1. Питание

Откуда | Куда | Провод
18650 «+» | SW1 → MT3608 IN+ | 0,5 мм²
18650 «−» | MT3608 IN− | 0,5 мм²
MT3608 OUT+ | JP_PWR → Nano 5V, оба VCC джойстиков, YL‑105 VCC | 0,35–0,5 мм² магистраль
MT3608 OUT− | Nano GND, оба GND джойстиков, YL‑105 GND | 0,35–0,5 мм² магистраль
Шина +5 В | R10 1 кОм → анод LED1; катод LED1 → общий GND | 0,2 мм²

#### 2. Джойстики

Контакт | Левый → Nano | Правый → Nano
VCC | +5 В | +5 В
GND | GND | GND
VRx | A0 | A2
VRy | A1 | A3
SW | D3 · INPUT_PULLUP | D4 · INPUT_PULLUP

#### 3. Радио: Nano → YL‑105

Nano | Через | На YL‑105 | Ответвление от входа YL‑105
D9 | R1 1 кОм | CE | R2 1,8 кОм → GND
D10 | R3 1 кОм | CSN | R4 1,8 кОм → GND
D13 / SCK | R5 1 кОм | SCK | R6 1,8 кОм → GND
D11 / MOSI | R7 1 кОм | MO / MOSI | R8 1,8 кОм → GND
D12 / MISO | прямой провод | MI / MISO | запас по логическому уровню мал; при сбоях нужен буфер AHCT125
D10 | R9 10 кОм → +5 В | подтяжка на стороне Nano до R3 | —
— | не подключать | IRQ | опрос радио по SPI

Nano D9 (5 В)─ R1 1 кОм ─● CE (≈3,2 В)─ YL‑105 CE└ R2 1,8 кОм → GND

#### 4. Адаптер и конденсаторы

Узел | Подключение
YL‑105 VCC / GND | +5 В / общий GND от MT3608
nRF24L01+PA/LNA | В гнездо YL‑105 после проверки ориентации модуля
C1 10 мкФ, электролит | «+» к выходу 3,3 В YL‑105 у радиогнезда; «−» к GND
C2 100 нФ, керамика | Параллельно C1, на 3,3 В и GND у радиогнезда

Провода сигналов и джойстиков — 0,2 мм². Перед подключением Nano настроить выход MT3608 на 5,0 В, подавать его на 5V, не VIN; после сборки проверить 5 В при передаче радио. Если 18650 без встроенной защиты, нужна отдельная защита 1S от переразряда. Все контакты сверять по надписям на самих модулях; радиомодуль без подписей вставлять только после проверки ориентации.

У радио на плате паука вход адаптера YL‑105 получает 5 В; радиомодуль получает 3,3 В с адаптера. У пульта та же схема питания радио.
