gbq38u/spider_gaming/wiring/platav2/схема электроники.pdf

## Паук: питание, управление и 24 сервопривода

Функциональная схема платы v13. Три плюсовые группы серв независимы; земля общая.

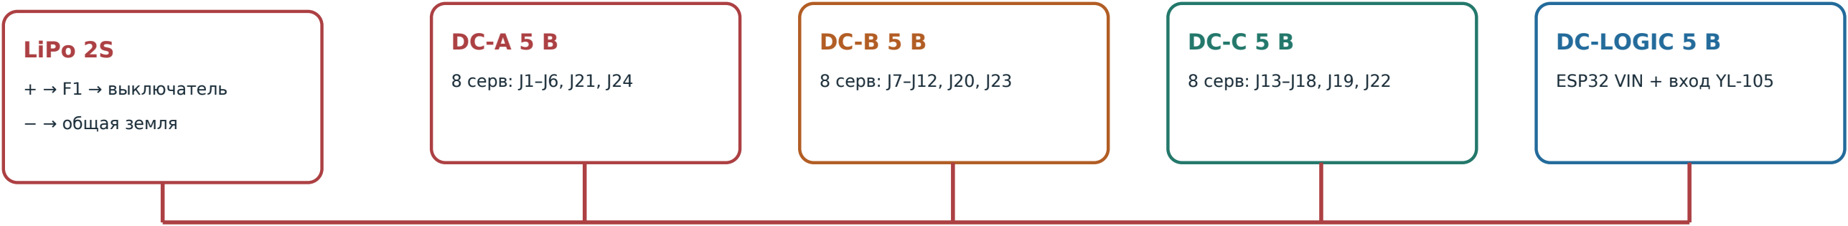
[picture p65: figure]
LiPo 2S; + → F1 → выключатель; − → общая земля; 8 серв: J1–J6, J21, J24; 8 серв: J7–J12, J20, J23; 8 серв: J13–J18, J19, J22; DC-LOGIC 5 В; ESP32 VIN + вход YL-105
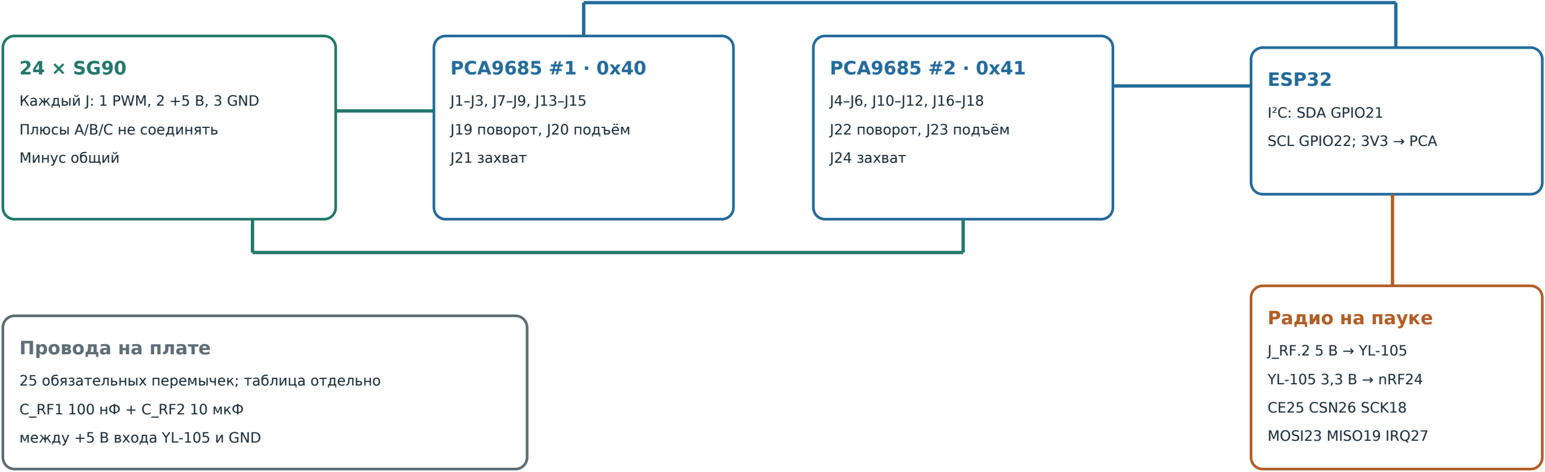
[picture p66: figure]
ESP32; I²C: SDA GPIO21; SCL GPIO22; 3V3 → PCA; PCA9685 #1 · 0x40; J19 поворот, J20 подъём; J21 захват; PCA9685 #2 · 0x41; J22 поворот, J23 подъём; J24 захват; Каждый J: 1 PWM, 2 +5 В, 3 GND; Плюсы A/B/C не соединять; Минус общий; Радио на пауке; YL-105 3,3 В → nRF24; CE25 CSN26 SCK18; MOSI23 MISO19 IRQ27; Провода на плате; 25 обязательных перемычек; таблица отдельно; C_RF1 100 нФ + C_RF2 10 мкФ; между +5 В входа YL-105 и GND

Детали устанавливаются сверху, паяются снизу. Эта схема — монтажная, а не Gerber для изготовления.
