gbq38u/spider_gaming/wiring/platav1/подключение.pdf

# Куда устанавливать компоненты

### ESP32

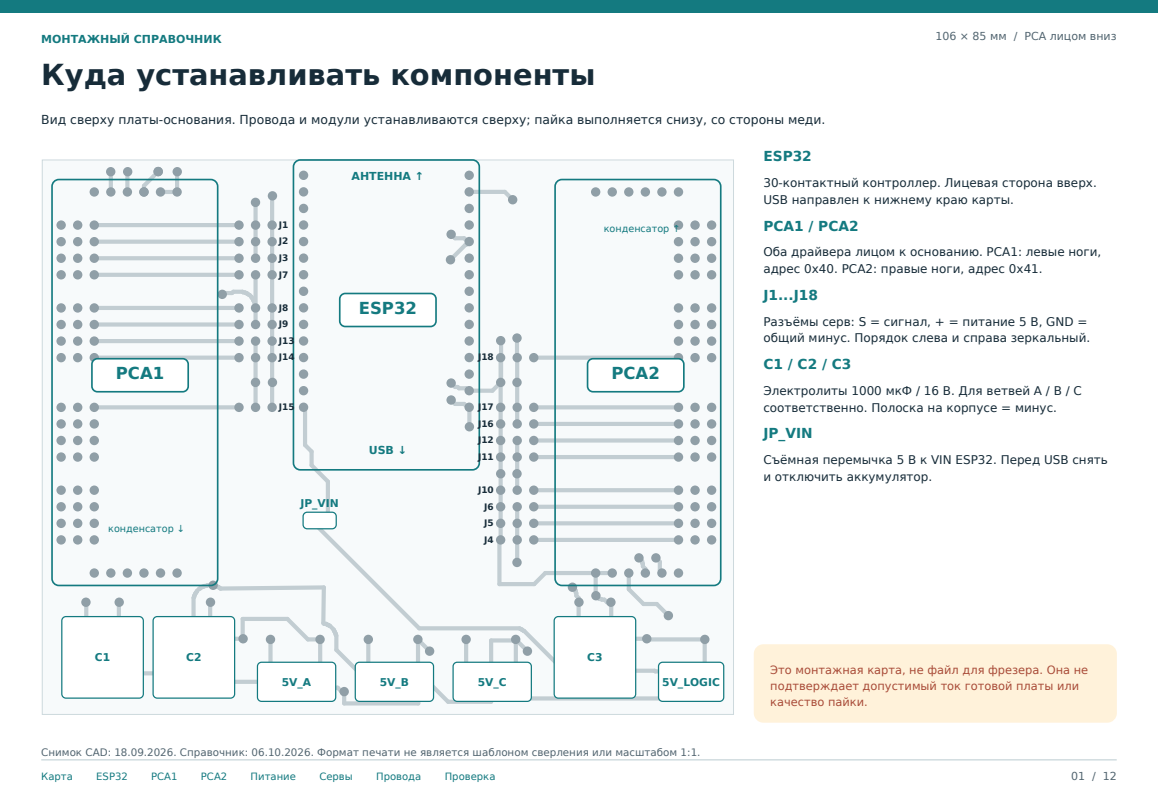
[picture p67: page 1]

106 × 85 мм / PCA лицом вниз

Вид сверху платы-основания. Провода и модули устанавливаются сверху; пайка выполняется снизу, со стороны меди.

30-контактный контроллер. Лицевая сторона вверх.
USB направлен к нижнему краю карты.
PCA1 / PCA2

Оба драйвера лицом к основанию. PCA1: левые ноги,
адрес 0x40. PCA2: правые ноги, адрес 0x41.

Разъёмы серв: S = сигнал, + = питание 5 В, GND =
общий минус. Порядок слева и справа зеркальный.

Электролиты 1000 мкФ / 16 В. Для ветвей A / B / C
соответственно. Полоска на корпусе = минус.
JP_VIN

Съёмная перемычка 5 В к VIN ESP32. Перед USB снять
и отключить аккумулятор.

Это монтажная карта, не файл для фрезера. Она не
подтверждает допустимый ток готовой платы или
качество пайки.

Снимок CAD: 18.09.2026. Справочник: 06.10.2026. Формат печати не является шаблоном сверления или масштабом 1:1.

# ESP32: все 30 выводов

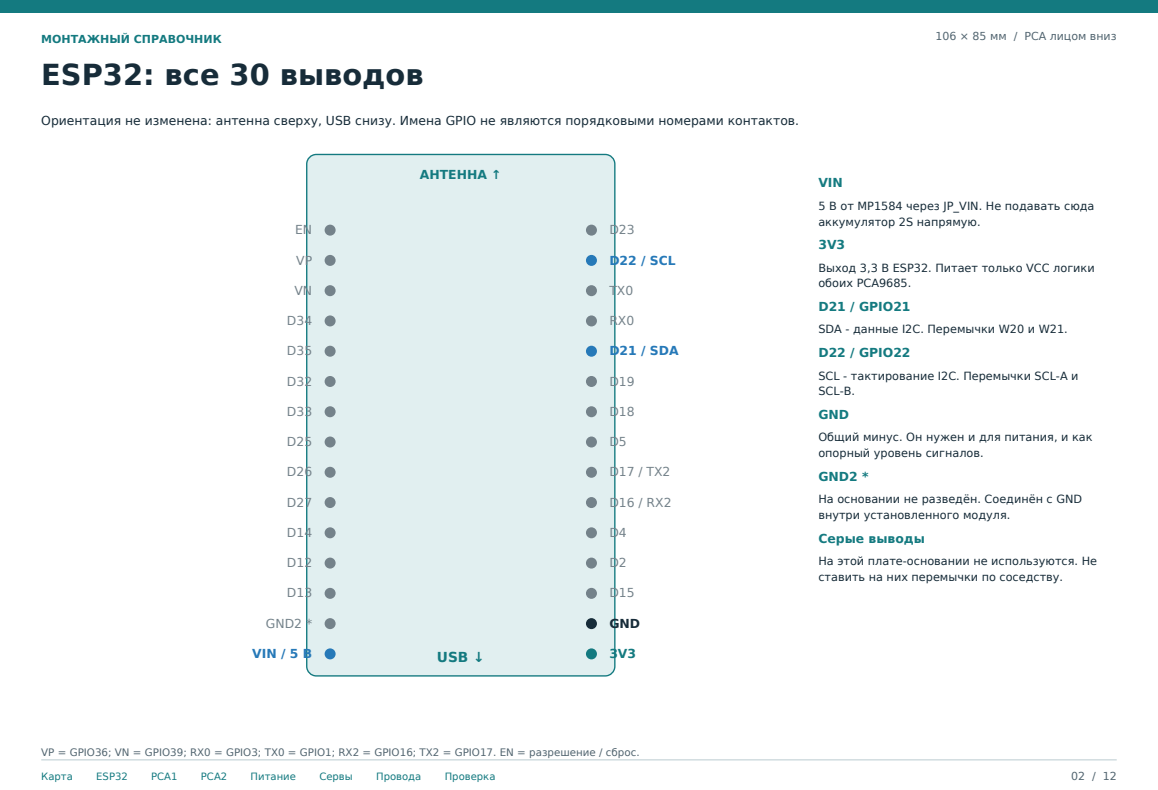
[picture p68: page 2]

Ориентация не изменена: антенна сверху, USB снизу. Имена GPIO не являются порядковыми номерами контактов.

5 В от MP1584 через JP_VIN. Не подавать сюда
аккумулятор 2S напрямую.

Выход 3,3 В ESP32. Питает только VCC логики
обоих PCA9685.
D21 / GPIO21

SCL - тактирование I2C. Перемычки SCL-A и
SCL-B.
GND

Общий минус. Он нужен и для питания, и как
опорный уровень сигналов.
GND2 *

На основании не разведён. Соединён с GND
внутри установленного модуля.
Серые выводы

На этой плате-основании не используются. Не
ставить на них перемычки по соседству.

VP = GPIO36; VN = GPIO39; RX0 = GPIO3; TX0 = GPIO1; RX2 = GPIO16; TX2 = GPIO17. EN = разрешение / сброс.

# PCA1: выводы драйвера, адрес 0x40

Карта | ESP32 | PCA1 | PCA2 | Питание | Сервы | Провода | Проверка | 03 / 12
Лицевая сторона обращена к плате-основанию. Показан вид сверху основания, как на общей карте. V+ [1] | VCC [2] | SDA [3] | SCL [4] | OE [5] | GND [6] V+ [7] | VCC [8] | SDA [9] | SCL [10] | OE [11] | GND [12]

13 14 15

CH15

16 17 18

CH14

19 20 21

CH13

22 23 24

CH12

25 26 27

CH11

28 29 30

CH10

31 32 33

CH9

34 35 36

CH8

37 38 39

CH7

40 41 42

CH6

43 44 45

CH5

46 47 48

CH4

49 50 51

CH3

52 53 54

CH2

55 56 57

CH1

58 59 60

CH0

G + S

C

Лицевой стороной к плате-основанию. Конденсатор направлен вниз. A0 разомкнут.

Обозначение | Функция на этой плате
G / GND | Общий минус. Через управляющую гребёнку.
+ / V+ | Силовая шина модуля. НЕ подключать к A/B/C.
S / PWM | Сигнал соответствующего канала CH.
VCC | 3,3 В от ESP32; питание логики.
SDA | Данные I2C от GPIO21 ESP32.
SCL | Тактовая линия I2C от GPIO22 ESP32.
OE | Соединён с GND: выходы разрешены.

Две шестиконтактные гребёнки дублируются внутри модуля. Одна из них не имеет дорожек на основании. Это не означает, что её выводы электрически изолированы.

Каналы после переворота: новый CH = 15 - старый CH. Используются CH15...CH7. Программа и исходный CAD автоматически не исправлены; старые имена CAD_CH0...8 не являются текущими номерами для прошивки.

Числа в квадратных скобках и под контактами - идентификаторы площадок посадочного места PCA (1...60), не номера ножек микросхемы.

G / + / S подписывают три столбца PWM-гребёнки. V+ на всех каналах общая внутри модуля, но в нашей разводке не используется.

# PCA2: выводы драйвера, адрес 0x41

Карта | ESP32 | PCA1 | PCA2 | Питание | Сервы | Провода | Проверка | 04 / 12
Лицевая сторона обращена к плате-основанию. Показан вид сверху основания, как на общей карте. GND [6] | OE [5] | SCL [4] | SDA [3] | VCC [2] | V+ [1] GND [12] | OE [11] | SCL [10] | SDA [9] | VCC [8] | V+ [7]

15 14 13

CH15

18 17 16

CH14

21 20 19

CH13

24 23 22

CH12

27 26 25

CH11

30 29 28

CH10

33 32 31

CH9

36 35 34

CH8

39 38 37

CH7

42 41 40

CH6

45 44 43

CH5

48 47 46

CH4

51 50 49

CH3

54 53 52

CH2

57 56 55

CH1

60 59 58

CH0

S + G

C

Лицевой стороной к плате-основанию. Конденсатор направлен вверх. A0 замкнут до установки.

Обозначение | Функция на этой плате
G / GND | Общий минус. Через управляющую гребёнку.
+ / V+ | Силовая шина модуля. НЕ подключать к A/B/C.
S / PWM | Сигнал соответствующего канала CH.
VCC | 3,3 В от ESP32; питание логики.
SDA | Данные I2C от GPIO21 ESP32.
SCL | Тактовая линия I2C от GPIO22 ESP32.
OE | Соединён с GND: выходы разрешены.

Две шестиконтактные гребёнки дублируются внутри модуля. Одна из них не имеет дорожек на основании. Это не означает, что её выводы электрически изолированы.

Каналы после переворота: новый CH = 15 - старый CH. Используются CH15...CH7. Программа и исходный CAD автоматически не исправлены; старые имена CAD_CH0...8 не являются текущими номерами для прошивки.

Числа в квадратных скобках и под контактами - идентификаторы площадок посадочного места PCA (1...60), не номера ножек микросхемы.

G / + / S подписывают три столбца PWM-гребёнки. V+ на всех каналах общая внутри модуля, но в нашей разводке не используется.

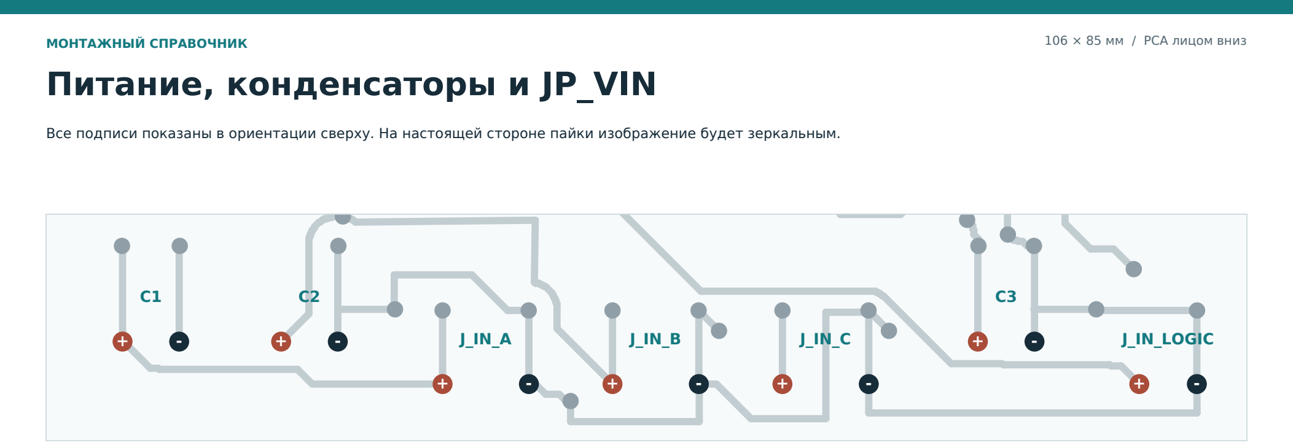
[picture p69: figure]
Питание, конденсаторы и JP_VIN; J_IN_LOGIC

Карта | ESP32 | PCA1 | PCA2 | Питание | Сервы | Провода | Проверка | 05 / 12

Все подписи показаны в ориентации сверху. На настоящей стороне пайки изображение будет зеркальным.

Обозначение | Что подключить | Пин 1 (+) | Пин 2 (-)
J_IN_A | UBEC A: передние ноги | +5V_A | GND
J_IN_B | UBEC B: средние ноги | +5V_B | GND
J_IN_C | UBEC C: задние ноги | +5V_C | GND
J_IN_LOGIC | MP1584: логика, выход 5 В | +5V_LOGIC | GND
C1 / C2 / C3 | 1000 мкФ / 16 В; ветви A / B / C | Плюс конденсатора | Полоска на корпусе

JP_VIN: 1 = 5V_LOGIC от MP1584; 2 = VIN ESP32. Для питания от аккумулятора замкнуть. Перед USB снять и отключить аккумулятор.

Не соединять плюсы A / B / C / LOGIC. На входы этой платы нельзя подавать аккумулятор напрямую. Все GND общие.

Показаны нижние реальные пары выводов конденсаторов, не расположенные выше площадки проводных перемычек.

# J1...J18: разъёмы сервоприводов

Карта | ESP32 | PCA1 | PCA2 | Питание | Сервы | Провода | Проверка | 06 / 12

Л / П = левая / правая сторона робота. 1 / 2 / 3 = передняя / средняя / задняя нога.

Разъём | Нога / сустав | Драйвер | Физический CH | Питание
J1 | Л1 / поворот | PCA1 | CH15 | +5V_A
J2 | Л1 / бедро | PCA1 | CH14 | +5V_A
J3 | Л1 / голень | PCA1 | CH13 | +5V_A
J4 | П1 / поворот | PCA2 | CH15 | +5V_A
J5 | П1 / бедро | PCA2 | CH14 | +5V_A
J6 | П1 / голень | PCA2 | CH13 | +5V_A
J7 | Л2 / поворот | PCA1 | CH12 | +5V_B
J8 | Л2 / бедро | PCA1 | CH11 | +5V_B
J9 | Л2 / голень | PCA1 | CH10 | +5V_B
J10 | П2 / поворот | PCA2 | CH12 | +5V_B
J11 | П2 / бедро | PCA2 | CH11 | +5V_B
J12 | П2 / голень | PCA2 | CH10 | +5V_B
J13 | Л3 / поворот | PCA1 | CH9 | +5V_C
J14 | Л3 / бедро | PCA1 | CH8 | +5V_C
J15 | Л3 / голень | PCA1 | CH7 | +5V_C
J16 | П3 / поворот | PCA2 | CH9 | +5V_C
J17 | П3 / бедро | PCA2 | CH8 | +5V_C
J18 | П3 / голень | PCA2 | CH7 | +5V_C

Каждый разъём

Контакт 1 = S / PWM, контакт 2 = +5 В своей ветви, контакт 3 = GND.

Левый банк, слева направо

S | +5 В | GND

Правый банк, слева направо

GND | +5 В | S

Почему CH15...CH7

Драйверы перевёрнуты лицом к основанию. Номер канала = 15 - старый номер CAD. В этой таблице уже физические номера после переворота.

Питание серв

Поступает от UBEC напрямую через основание. V+ PCA9685 остаётся без подключения.

Перед включением

Проверить полярность каждого штекера. На цвет провода полагаться только после проверки конкретного сервопривода.

Номера J обозначают разъёмы на основании, а CH - выходы драйвера. Это разные системы обозначений.

# Перемычки: 16 соединений

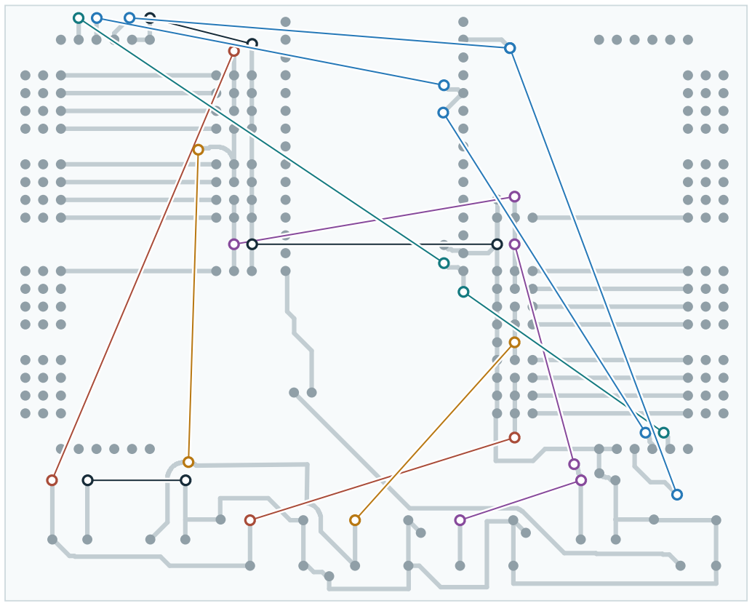
[picture p70: figure]

Карта | ESP32 | PCA1 | PCA2 | Питание | Сервы | Провода | Проверка | 07 / 12

Линии показывают только электрические концы, не обязательный маршрут укладки. Каждый провод должен быть изолирован.

Провод | Цепь | Карточка
W1 | +5V_A | 8
W2 | +5V_A | 8
W3 | +5V_B | 8
W4 | +5V_B | 8
W5 | +5V_C | 9
W6 | +5V_C | 9
W7 | +5V_C | 9
W8 | GND | 9
W14 | GND | 10
W16 | GND | 10
W18 | +3V3 | 10
W19 | +3V3 | 10
W20 | I2C_SDA | 11
W21 | I2C_SDA | 11
SCL-A | I2C_SCL | 11
SCL-B | I2C_SCL | 11

Старые W9 / W10 / W11 / W12 / W13 / W15 / W17 уже заменены соединениями медью в этом снимке. Добавлять их как обязательные провода не нужно.

Нажмите строку списка для перехода к карточке. Внизу каждой страницы есть переходы к разделам; также доступны закладки PDF.

# Провода W1 / W2 / W3 / W4

## W1 / +5V_A

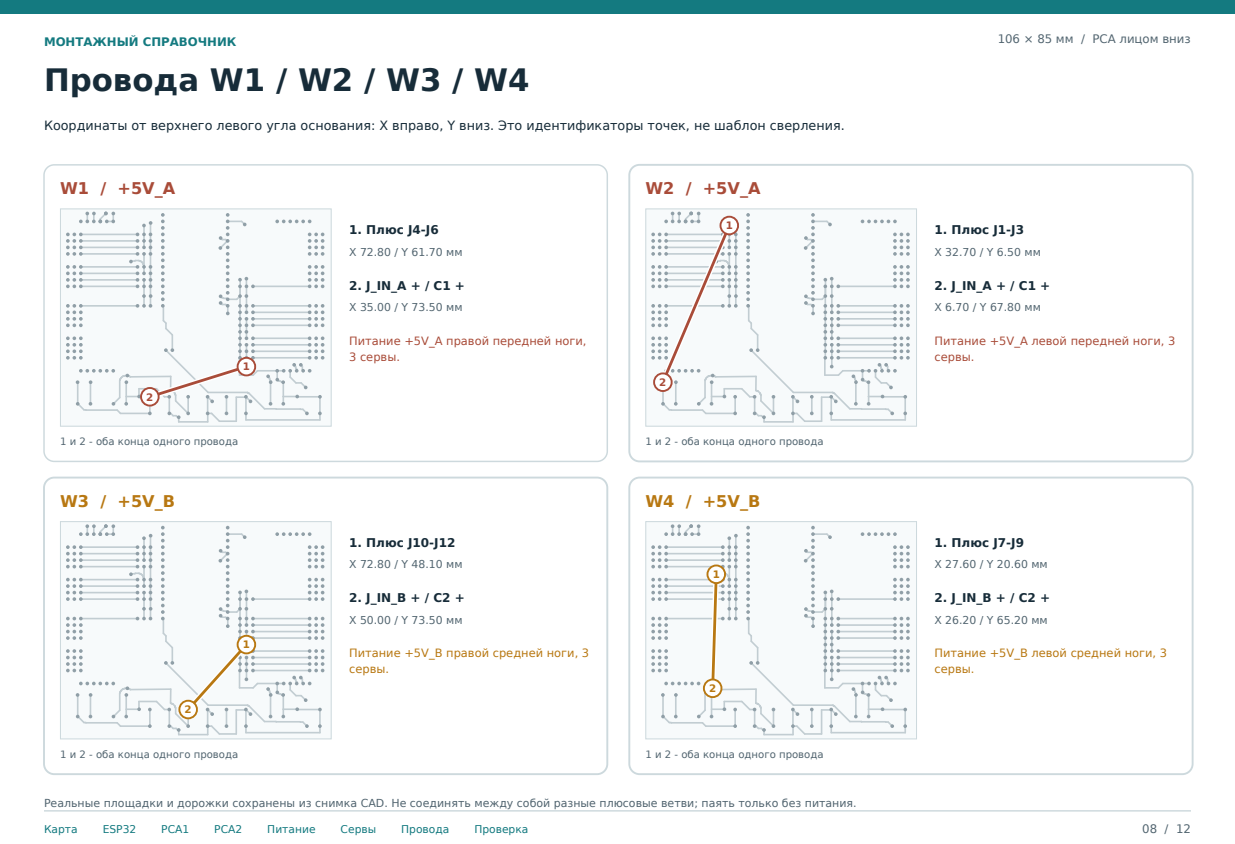
[picture p71: page 8]
Карта; ESP32; PCA1; PCA2; Питание; Сервы; Провода; Проверка; 1. Плюс J4-J6; 1. Плюс J1-J3; 1. Плюс J10-J12; 1. Плюс J7-J9

Координаты от верхнего левого угла основания: X вправо, Y вниз. Это идентификаторы точек, не шаблон сверления.

Питание +5V_A правой передней ноги,
3 сервы.

Питание +5V_A левой передней ноги, 3
сервы.

1 и 2 - оба конца одного провода

Питание +5V_B правой средней ноги, 3

Питание +5V_B левой средней ноги, 3

Реальные площадки и дорожки сохранены из снимка CAD. Не соединять между собой разные плюсовые ветви; паять только без питания.

# Провода W5 / W6 / W7 / W8

## W5 / +5V_C

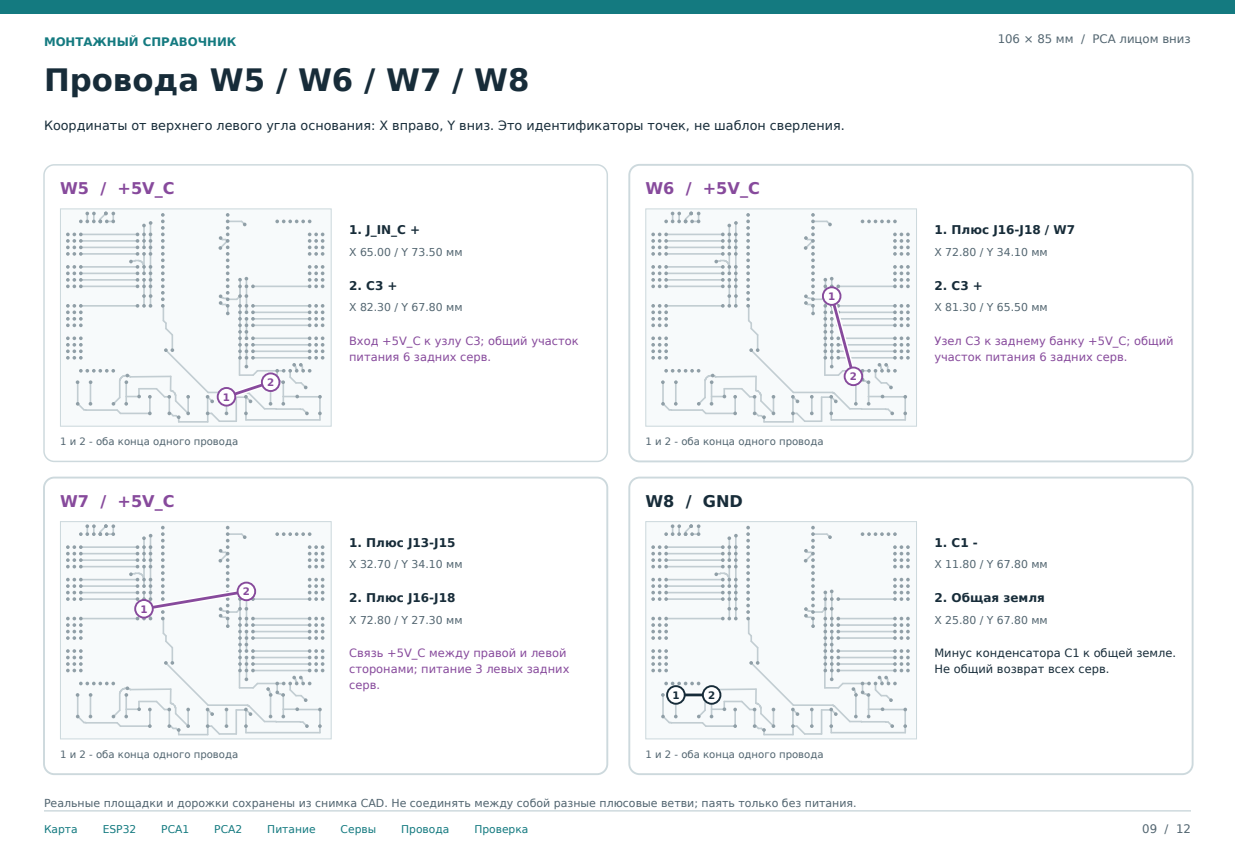
[picture p72: page 9]
Карта; ESP32; PCA1; PCA2; Питание; Сервы; Провода; Проверка; 1. Плюс J16-J18 / W7; 1. Плюс J13-J15; 2. Плюс J16-J18; W8 / GND; 2. Общая земля

Координаты от верхнего левого угла основания: X вправо, Y вниз. Это идентификаторы точек, не шаблон сверления.

Вход +5V_C к узлу C3; общий участок
питания 6 задних серв.

Узел C3 к заднему банку +5V_C; общий
участок питания 6 задних серв.

1 и 2 - оба конца одного провода

Связь +5V_C между правой и левой
сторонами; питание 3 левых задних
серв.

Минус конденсатора C1 к общей земле.
Не общий возврат всех серв.

Реальные площадки и дорожки сохранены из снимка CAD. Не соединять между собой разные плюсовые ветви; паять только без питания.

# Провода W14 / W16 / W18 / W19

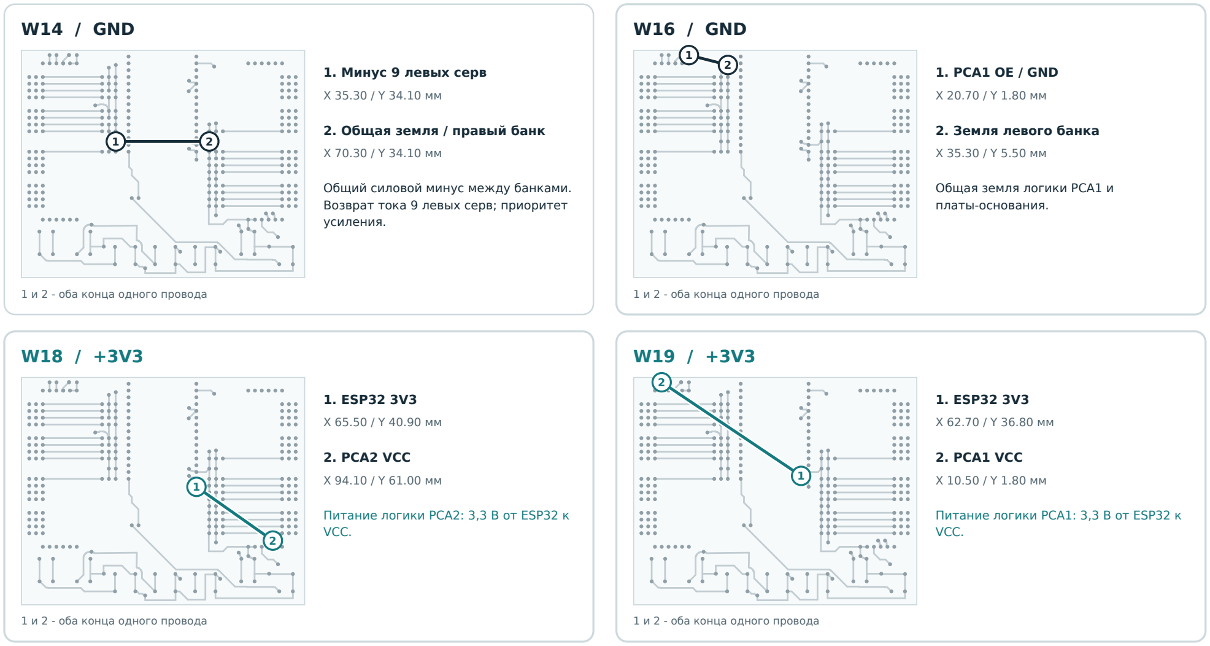
[picture p73: figure]
W14 / GND; 1. Минус 9 левых серв; 2. Общая земля / правый банк; 1 и 2 - оба конца одного провода; Общий силовой минус между банками. Возврат тока 9 левых серв; приоритет усиления.; W16 / GND; 1. PCA1 OE / GND; 2. Земля левого банка; Общая земля логики PCA1 и платы-основания.; 1. ESP32 3V3; 2. PCA2 VCC; Питание логики PCA2: 3,3 В от ESP32 к VCC.; 2. PCA1 VCC; Питание логики PCA1: 3,3 В от ESP32 к VCC.

Карта | ESP32 | PCA1 | PCA2 | Питание | Сервы | Провода | Проверка | 10 / 12

Координаты от верхнего левого угла основания: X вправо, Y вниз. Это идентификаторы точек, не шаблон сверления.

Реальные площадки и дорожки сохранены из снимка CAD. Не соединять между собой разные плюсовые ветви; паять только без питания.

# Провода W20 / W21 / SCL-A / SCL-B

## W20 / I2C_SDA

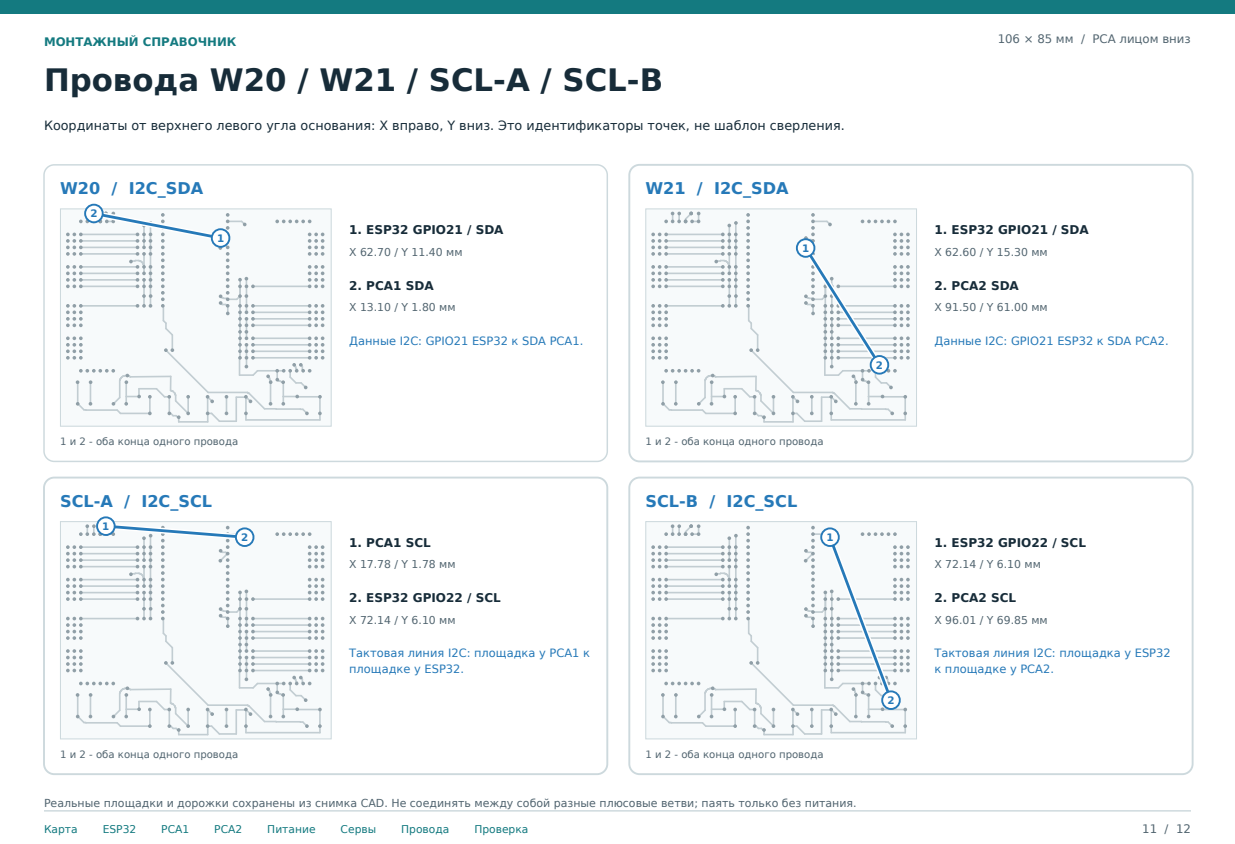
[picture p74: page 11]
Карта; ESP32; PCA1; PCA2; Питание; Сервы; Провода; Проверка; 1. ESP32 GPIO21 / SDA; 2. PCA1 SDA; Данные I2C: GPIO21 ESP32 к SDA PCA1.; W21 / I2C_SDA; 2. PCA2 SDA; Данные I2C: GPIO21 ESP32 к SDA PCA2.; SCL-A / I2C_SCL; 2 1. PCA1 SCL; 2. ESP32 GPIO22 / SCL; SCL-B / I2C_SCL; 1. ESP32 GPIO22 / SCL; 2. PCA2 SCL

Координаты от верхнего левого угла основания: X вправо, Y вниз. Это идентификаторы точек, не шаблон сверления.

1 и 2 - оба конца одного провода

Тактовая линия I2C: площадка у PCA1 к
площадке у ESP32.

Тактовая линия I2C: площадка у ESP32
к площадке у PCA2.

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

# Расшифровка и проверка перед питанием

Карта | ESP32 | PCA1 | PCA2 | Питание | Сервы | Провода | Проверка | 12 / 12
Обозначение | Что означает
GND | Общий минус питания и опорный потенциал сигналов.
S / PWM | Управляющий сигнал сервопривода, не его питание.
VCC | Питание логики PCA9685, здесь 3,3 В.
V+ | Общая силовая шина PCA9685, здесь НЕ подключена.
SDA / SCL | Данные / тактирование шины I2C.
OE | Разрешение выходов PCA9685; здесь соединён с GND.
5V_A / B / C | Три отдельных выхода UBEC: передние / средние / задние ноги.
5V_LOGIC | Выход MP1584, 5 В для ESP32 через JP_VIN.
VIN / 3V3 | Вход питания ESP32 / выход 3,3 В его стабилизатора.
CH0...CH15 | Номера PWM-каналов PCA9685.
NC / не разведён | Нет дорожки на основании; внутри установленного модуля соединение может существовать.
F1 / F2 / S1 | Предохранители 20 А / 2 А и выключатель; расположены ВНЕ платы.

### 1. Полярность и изоляция

Проверить + / - всех входов, конденсаторов и серв. Убедиться, что припой и оголённые жилы не замыкают соседние дорожки.

### 2. Перевёрнутые PCA

Проверить расположение GND / V+ / PWM, каналы CH15...CH7 и высоту гнёзд. Конденсатор и клеммник не должны касаться платы или проводов.

### 3. Логика

MP1584 заранее настроен на 5 В. PCA VCC питается от 3,3 В ESP32; V+ не подключён. PCA1 A0 открыт; PCA2 A0 замкнут.

### 4. Силовая часть

Карта не подтверждает допустимый ток провода 0,2 мм², дорожек или пайки. W14 - приоритет усиления; W5/W6 также общие силовые участки.

### 5. USB и аккумулятор

Перед подключением USB снять JP_VIN и отключить аккумулятор. Не паять при подключённом питании.

Границы этого документа

Справочник создан из снимка CAD от 18.09.2026 с монтажной ориентацией, согласованной позже. Фактическая плата и пайка не осмотрены. Это не производственный выпуск и не G-code.

Открыть исходный проект EasyEDA (https://easyeda.com/editor#id=b3a8a3ed83c54372b00acf45fa82e8ee)

Для выбора компонента или отдельного пина используйте автономный HTML-файл из того же комплекта. PDF предназначен для чтения и печати.
