gbq38u/spider_gaming/wiring/platav2/README.txt

Монтажные материалы для платы робота v13 и пульта (03.11.2026)

Основная плата: 106 × 85 мм, 24 выхода SG90, два PCA9685 0x40/0x41.
Источник: carrier24-v13-netlist-audit.json, проверка passed=true.

интерактивная плата.html — самостоятельная офлайн-карта 25 проводных соединений;
подключение платы.pdf — карта платы, таблица перемычек, компоненты и разъёмы;
схема электроники.pdf — питание и функциональные блоки робота;
интерактивный пульт.html — самостоятельная офлайн-схема пульта;
подключение пульта.pdf — подробные соединения Nano/джойстиков/радио;
схема пульта.pdf — краткая функциональная схема пульта.

Пульт: 18650 1S, MT3608 5,0 В, Arduino Nano 5 В, два XY-джойстика,
YL-105 и nRF24L01+ PA/LNA. Конденсаторы 10 мкФ и 100 нФ пульта стоят
на выходе 3,3 В YL-105. C_RF1/C_RF2 основной платы стоят на входе 5 В.

Файлы предназначены для монтажа и проверки подключений. Gerber в архив
не входит. Сверьте физическое расположение серв, ориентацию джойстиков
и реальные пределы клешней перед первым запуском.
