gbq38u/spider_gaming/wiring/platav2/интерактивная плата.html

# Плата v13 — монтаж и перемычки

Нажмите на провод и переключайте вид сверху / снизу. Синие соединения повторяют предыдущую плату, оранжевые добавлены в v13.

### Провода для платы 24 сервоприводов · 106 × 85 мм

Показать Выбрать провод Вид

Как на первой плате Новое соединение

## Выходы для ног

Разъёмы | Нога | Драйвер / каналы | Питание
J1–J3 | Левая передняя | 0x40, CH15–13 | +5V_A
J4–J6 | Правая передняя | 0x41, CH15–13 | +5V_A
J7–J9 | Левая средняя | 0x40, CH12–10 | +5V_B
J10–J12 | Правая средняя | 0x41, CH12–10 | +5V_B
J13–J15 | Левая задняя | 0x40, CH9–7 | +5V_C
J16–J18 | Правая задняя | 0x41, CH9–7 | +5V_C

В каждой тройке разъёмы идут в порядке: поворот, бедро, голень. Фактическое подключение серв проверьте по своей сборке.

## Выходы для клешней

Разъём | Действие | Драйвер / канал | Питание
J19 / J22 | Поворот левой / правой | 0x40 / 0x41, CH6 | +5V_C
J20 / J23 | Подъём левой / правой | 0x40 / 0x41, CH5 | +5V_B
J21 / J24 | Захват левой / правой | 0x40 / 0x41, CH4 | +5V_A

На J1–J24: 1 = сигнал, 2 = плюс своей группы, 3 = общая земля. Плюсы A, B и C между собой не соединять.

## Радио и питание

J_RF: 1 GND; 2 +5V_LOGIC на вход YL‑105; 3 CE/GPIO25; 4 CSN/GPIO26; 5 SCK/GPIO18; 6 MOSI/GPIO23; 7 MISO/GPIO19; 8 IRQ/GPIO27. Сам nRF24L01+ питается 3,3 В с выхода YL‑105. C_RF1 100 нФ и C_RF2 10 мкФ стоят между входными +5 В и GND адаптера.

Важное отличие платы: источник — односторонняя v13 без маски и металлизации. 25 показанных соединений нужно выполнить проводами. Размер 106 × 85 мм.
