gbq38u/spider_gaming/wiring/platav1/схема электроники.pdf

# Вся электроника на одном листе

## LiPo 2S / XT60

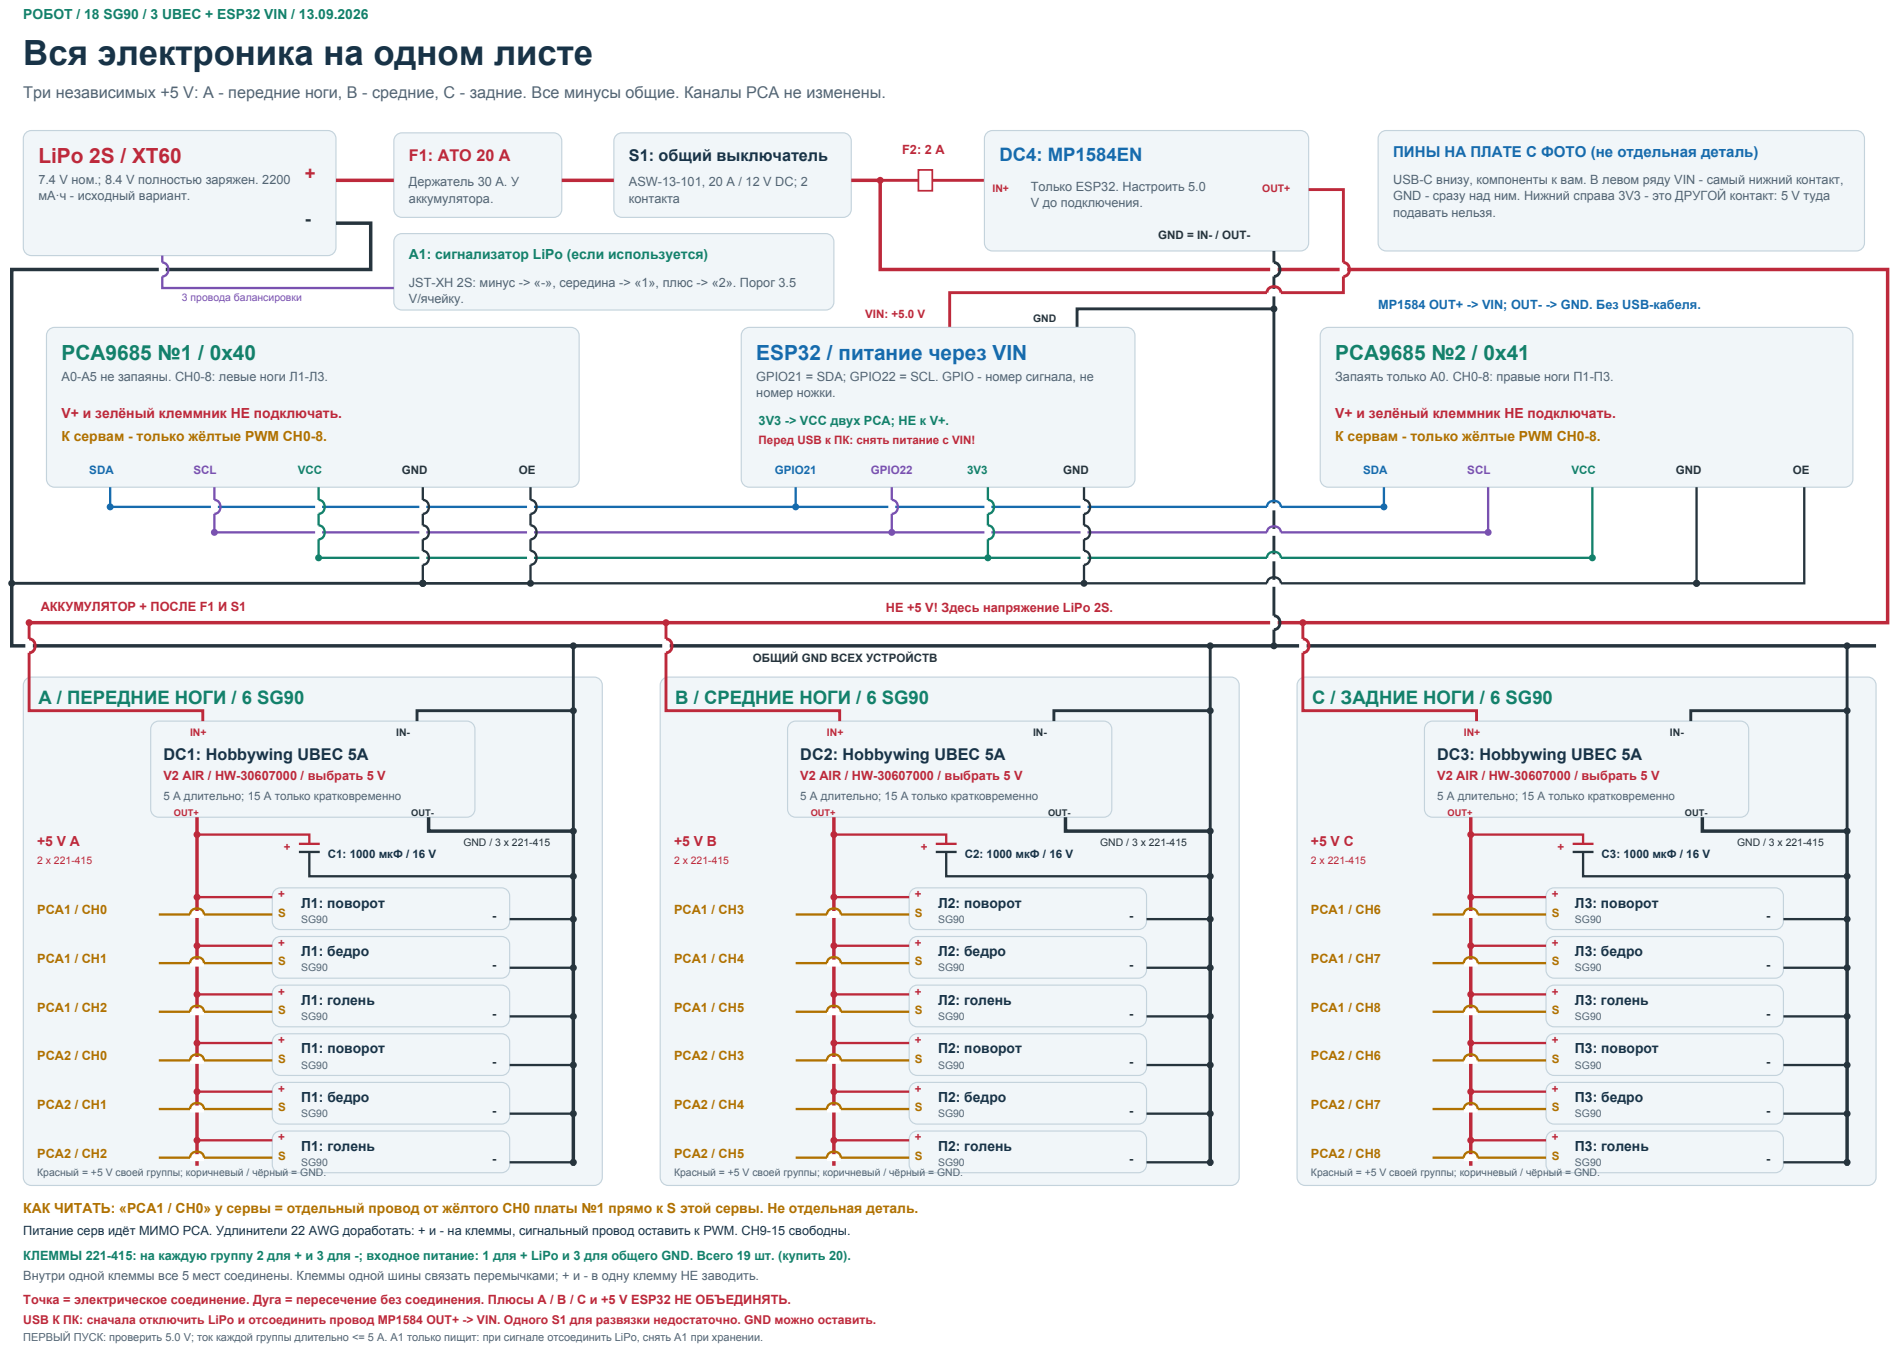
[picture p75: page 1]
F1: ATO 20 A; Держатель 30 A. У аккумулятора.; S1: общий выключатель; ASW-13-101, 20 A / 12 V DC; 2 контакта; Только ESP32. Настроить 5.0 V до подключения.; OUT+; VIN: +5.0 V; GND; 3 провода балансировки; V/ячейку.; PCA9685 №1 / 0x40; PCA9685 №2 / 0x41; SDA; SCL; VCC; GPIO21; GPIO22; АККУМУЛЯТОР + ПОСЛЕ F1 И S1; НЕ +5 V! Здесь напряжение LiPo 2S.; A / ПЕРЕДНИЕ НОГИ / 6 SG90; OUT-; GND / 3 x 221-415 + C1: 1000 мкФ / 16 V; Л1: поворот; PCA1 / CH0; Л1: бедро; PCA1 / CH1; Л1: голень; PCA1 / CH2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

РОБОТ / 18 SG90 / 3 UBEC + ESP32 VIN / 13.09.2026

Три независимых +5 V: A - передние ноги, B - средние, C - задние. Все минусы общие. Каналы PCA не изменены.

ПИНЫ НА ПЛАТЕ С ФОТО (не отдельная деталь)

7.4 V ном.; 8.4 V полностью заряжен. 2200
мА·ч - исходный вариант.

USB-C внизу, компоненты к вам. В левом ряду VIN - самый нижний контакт,
GND - сразу над ним. Нижний справа 3V3 - это ДРУГОЙ контакт: 5 V туда
подавать нельзя.

GND = IN- / OUT-

A1: сигнализатор LiPo (если используется)

JST-XH 2S: минус -> «-», середина -> «1», плюс -> «2». Порог 3.5

MP1584 OUT+ -> VIN; OUT- -> GND. Без USB-кабеля.

ESP32 / питание через VIN

A0-A5 не запаяны. CH0-8: левые ноги Л1-Л3.

GPIO21 = SDA; GPIO22 = SCL. GPIO - номер сигнала, не
номер ножки.

Запаять только A0. CH0-8: правые ноги П1-П3.

V+ и зелёный клеммник НЕ подключать.
К сервам - только жёлтые PWM CH0-8.

3V3 -> VCC двух PCA; НЕ к V+.
Перед USB к ПК: снять питание с VIN!

ОБЩИЙ GND ВСЕХ УСТРОЙСТВ

DC1: Hobbywing UBEC 5A
V2 AIR / HW-30607000 / выбрать 5 V
5 A длительно; 15 A только кратковременно

DC2: Hobbywing UBEC 5A

DC3: Hobbywing UBEC 5A

Красный = +5 V своей группы; коричневый / чёрный = GND.

КАК ЧИТАТЬ: «PCA1 / CH0» у сервы = отдельный провод от жёлтого CH0 платы №1 прямо к S этой сервы. Не отдельная деталь.
Питание серв идёт МИМО PCA. Удлинители 22 AWG доработать: + и - на клеммы, сигнальный провод оставить к PWM. CH9-15 свободны.

КЛЕММЫ 221-415: на каждую группу 2 для + и 3 для -; входное питание: 1 для + LiPo и 3 для общего GND. Всего 19 шт. (купить 20).
Внутри одной клеммы все 5 мест соединены. Клеммы одной шины связать перемычками; + и - в одну клемму НЕ заводить.

Точка = электрическое соединение. Дуга = пересечение без соединения. Плюсы A / B / C и +5 V ESP32 НЕ ОБЪЕДИНЯТЬ.
USB К ПК: сначала отключить LiPo и отсоединить провод MP1584 OUT+ -> VIN. Одного S1 для развязки недостаточно. GND можно оставить.
ПЕРВЫЙ ПУСК: проверить 5.0 V; ток каждой группы длительно <= 5 A. A1 только (https://www.hobbywingdirect.com/products/ubec-5a-air) пищит: при сигнале отсоединить LiPo, снять A1 при хранении.
