gbq38u/spider_gaming/wiring/platav2/подключение пульта.pdf

# Все подключения: Nano + 2 джойстика + nRF24L01+ PA/LNA

### 1. ПИТАНИЕ ОТ ОДНОЙ 18650

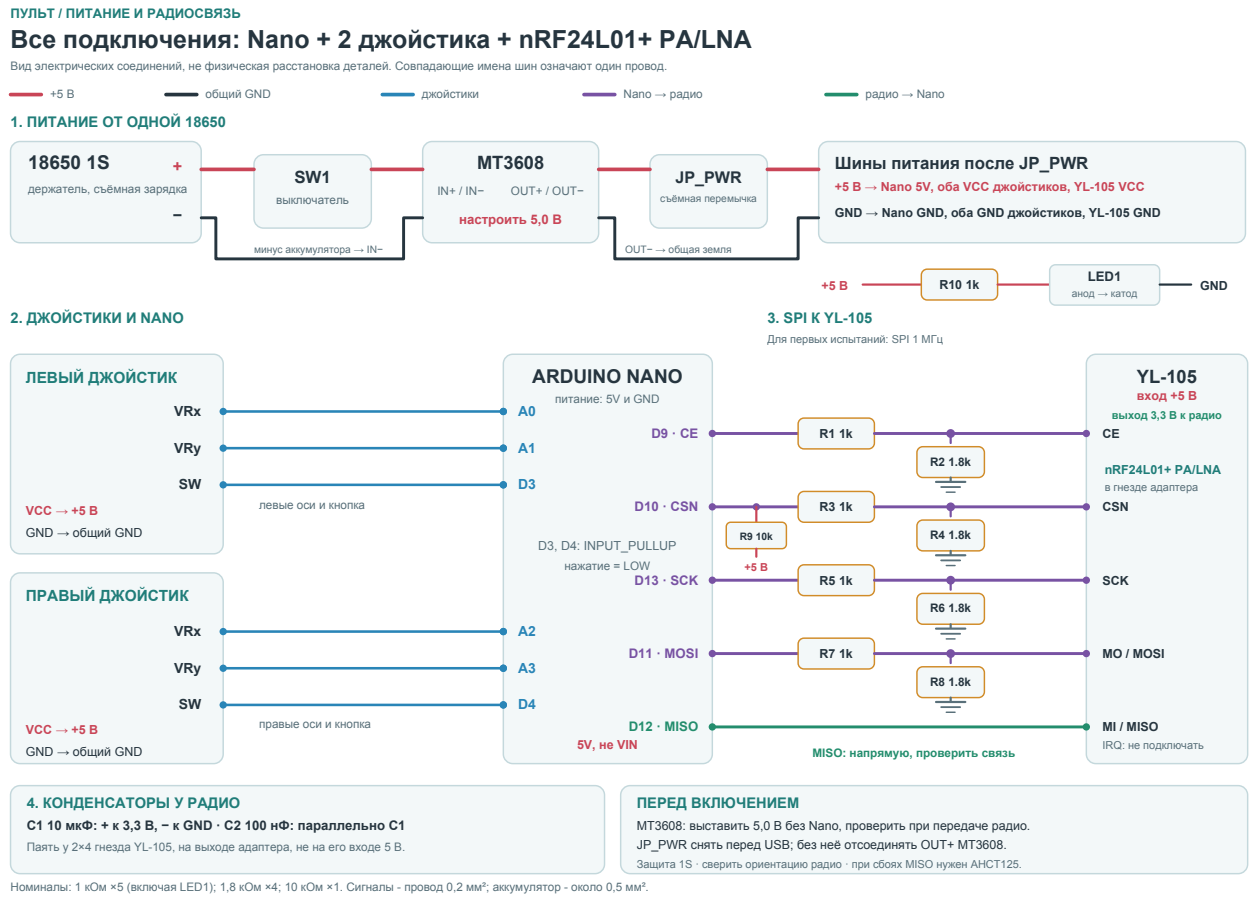
[picture p76: page 1]

Вид электрических соединений, не физическая расстановка деталей. Совпадающие имена шин означают один провод.

+5 В → Nano 5V, оба VCC джойстиков, YL-105 VCC

GND → Nano GND, оба GND джойстиков, YL-105 GND

Для первых испытаний: SPI 1 МГц

MISO: напрямую, проверить связь

4. КОНДЕНСАТОРЫ У РАДИО
C1 10 мкФ: + к 3,3 В, − к GND · C2 100 нФ: параллельно C1

MT3608: выставить 5,0 В без Nano, проверить при передаче радио.
JP_PWR снять перед USB; без неё отсоединять OUT+ MT3608.

Паять у 2×4 гнезда YL-105, на выходе адаптера, не на его входе 5 В.

Защита 1S · сверить ориентацию радио · при сбоях MISO нужен AHCT125.

Номиналы: 1 кОм ×5 (включая LED1); 1,8 кОм ×4; 10 кОм ×1. Сигналы - провод 0,2 мм²; аккумулятор - около 0,5 мм².
