gbq38u/spider_gaming/plate/platev2/PCB_carrier24-v07-yl105-5v-NOT-FOR-PRODUCTION.easyeda_2026-10-17 (1).pdf

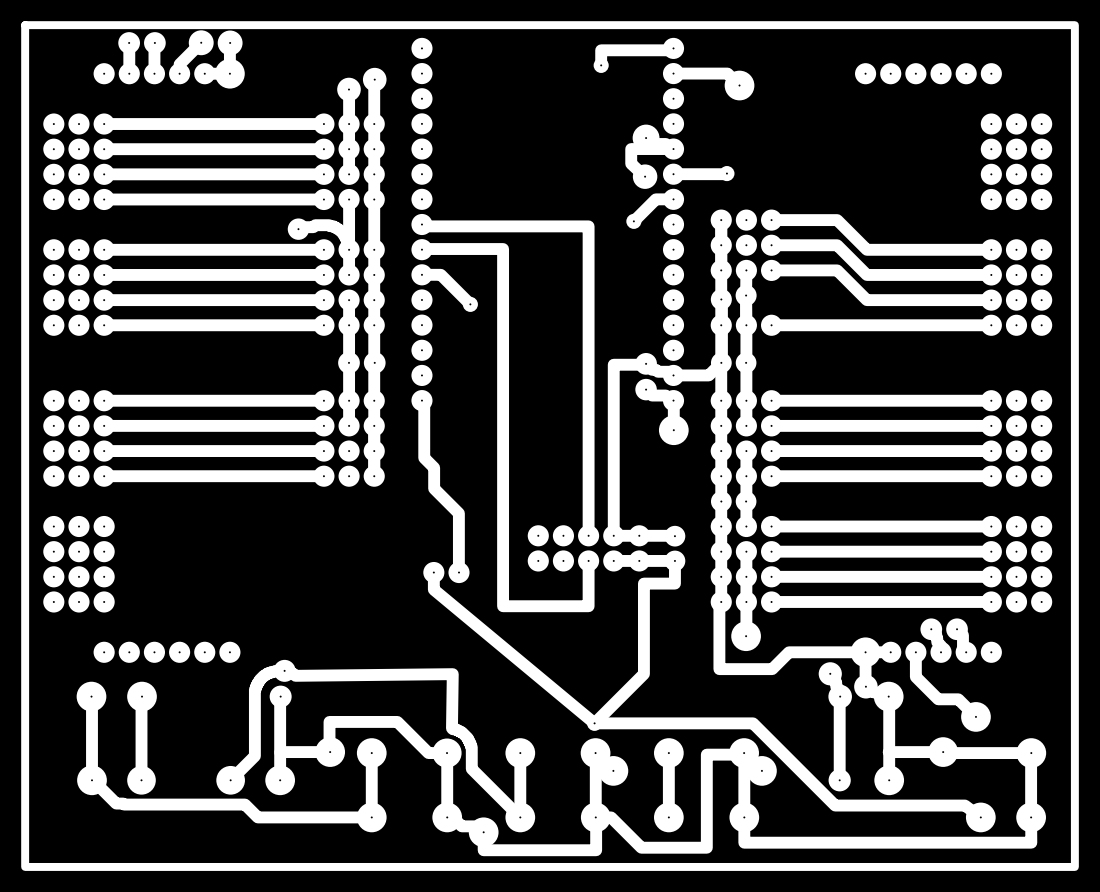
[picture p77: page 1]
