gbq38u/spider_gaming/plate/platev1/PCB_Compact-carrier-v0.2-NOT-FOR-CNC_2026-09-18.pdf

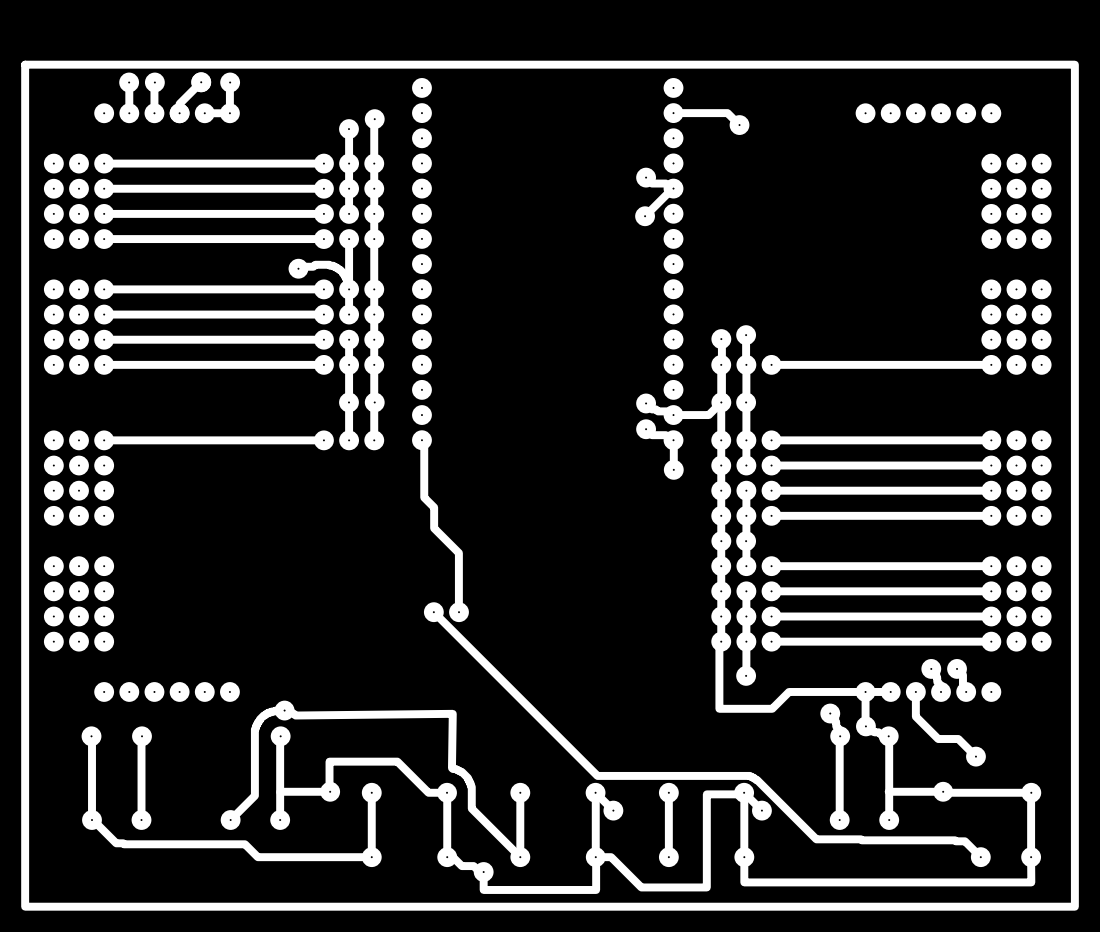
[picture p78: page 1]
