gbq38u/spider_gaming/code/esp_spider4/structs.h

#ifndef STRUCTS_H
#define STRUCTS_H

#include <stdint.h>

#define STDNUMOFSTEPS 12
#define STDSTEPTIME   0.2f

typedef struct
{
  float pos[3];
  float vels[3];
} point_t;

typedef struct
{
  point_t start; // in angles
  point_t end;   // in angles
  float   coefficients[3][4]; // Hermite interpolation coefs
  float   StepTime;
} step_t;

typedef struct
{
  int     NumOfSteps;
  step_t  Steps[STDNUMOFSTEPS];
} cycle_t;

typedef struct
{
  int     CurrStepInd;
  int64_t StepStartTimeUS;
  cycle_t Cycle;
  cycle_t Inertial;
} leg_cycle_t;

typedef struct {
  uint8_t driver;
  uint8_t channel;
} servo_port_t;

typedef struct {
  servo_port_t ServoPorts[3];
  float        ServoAngles[3];
} leg_servos_t;

typedef struct {
  float        LinkLengths[3];
  float        JointOffsets[3];
  float        BaseTranOffsets[3];
  float        BaseRotOffsets[3];
  float        JointHome[3];
  float        EFHome[3];
} leg_geometry_t;

typedef struct
{
  leg_servos_t   Servos;
  leg_geometry_t Geometry;
  leg_cycle_t    Cycle;
} leg_t;

typedef struct
{
  leg_t * Legs[6];
} spider_t;



/* ---------------------------------------------------------------- */
/*  point_init                                                      */
/*                                                                  */
/*  Copies a pos[3] and vel[3] into a point_t.                      */
/*  If vel is NULL, velocities are set to zero.                     */
/* ---------------------------------------------------------------- */
void point_init(point_t * point, const float * pos, const float * vel);

/* ---------------------------------------------------------------- */
/*  cycle_init_step                                                 */
/*                                                                  */
/*  Writes a single step: start/end points and StepTime, then       */
/*  computes the cubic Hermite coefficients for that step.          */
/*                                                                  */
/*  Polynomial (local time t ∈ [0, StepTime]):                      */
/*                                                                  */
/*      angle(t) = a·t³ + b·t² + c·t + d                            */
/*                                                                  */
/*  Coefficients stored in step->coefficients[joint][k]:            */
/*      [j][0] = a   (t³ term)                                      */
/*      [j][1] = b   (t² term)                                      */
/*      [j][2] = c   (t¹ term)                                      */
/*      [j][3] = d   (constant)                                     */
/*                                                                  */
/*  Derivation (with t1 = 0, h = StepTime, α = joint angle,         */
/*  α' = joint angular velocity):                                   */
/*                                                                  */
/*      a = (α₁' + α₂') / h²  −  2·Δα / h³                          */
/*      b = 3·Δα / h²  −  (2·α₁' + α₂') / h                         */
/*      c = α₁'                                                     */
/*      d = α₁                                                      */
/* ---------------------------------------------------------------- */
void cycle_init_step (cycle_t * cycle, int step_index, const point_t * start, const point_t * end, const float step_time);
void step_init(step_t * step, const point_t * start, const point_t * end, const float step_time);

/* Compute the cubic Hermite coefficients for a step, in local time t ∈ [0, StepTime].
 *
 * The stored polynomial is:
 *     angle(t) = a·t³ + b·t² + c·t + d
 *
 * Layout in coefficients[joint][k]:
 *     k = 0 → a  (t³ coefficient)
 *     k = 1 → b  (t² coefficient)
 *     k = 2 → c  (t¹ coefficient)
 *     k = 3 → d  (constant term)
 *
 * This matches the ESP32 evaluation order:
 *     angle = ((a * t + b) * t + c) * t + d;
 *
 * Inputs are read from step->start and step->end (pos = angle in rad, vels = ang vel in rad/s).
 * Output is written to step->coefficients.
 */
void update_step_coefficients(step_t * step);

/* ---------------------------------------------------------------- */
/*  cycle_init                                                      */
/*                                                                  */
/*  Fill an entire cycle from a pre-computed array of trajectory    */
/*  points. Points are assumed to be in joint-space (angles +       */
/*  angular velocities) — run doIK/doJacobian before calling this.  */
/*                                                                  */
/*  Writes NumOfSteps + 1 points, generating NumOfSteps segments:   */
/*      step[i].start = points[i]                                   */
/*      step[i].end   = points[i + 1]                               */
/*      step[i].StepTime = step_time                                */
/*      step[i].coefficients = cubic Hermite from the above         */
/*                                                                  */
/*  `points` must have at least NumOfSteps + 1 valid entries.       */
/*  Caller must ensure cycle->Steps is sized for NumOfSteps.        */
/* ---------------------------------------------------------------- */
void cycle_init(cycle_t * cycle, int NumOfSteps, const point_t * points, const float step_time);


#endif //STRUCTS_H
